embedded-pro/e-psu-hardware/simulation/results/cv_asdrawn.csv

fet | vout | rng | iload | cload | mode | fc | pm | gm | vout_meas | err
IRFP260N | 1.0 | 3A | 0.0 | 0.0 | CV | 315.00280664708674 | 37.479008982724054 |  | 1.00001945
IRFP260N | 1.0 | 3A | 0.1 | 0.0 | CV | 111112.34056282818 | -90.35583396529364 |  | 0.994687237
IRFP260N | 1.0 | 3A | 1.0 | 0.0 | CV | 180348.1509180765 | -58.49483802532512 |  | 0.949144151
IRFP260N | 1.0 | 3A | 3.0 | 0.0 | CV | 210124.91038821175 | -45.35260068004027 |  | 0.861490217
IRFP260N | 1.0 | 3A | 0.0 | 1e-06 | CV | 302.8120265973461 | 36.00394918867994 |  | 1.00001945
IRFP260N | 1.0 | 3A | 0.1 | 1e-06 | CV | 108853.3369042433 | -92.31889679006451 |  | 0.994687237
IRFP260N | 1.0 | 3A | 1.0 | 1e-06 | CV | 176492.19422361668 | -58.67569635580821 |  | 0.949144151
IRFP260N | 1.0 | 3A | 3.0 | 1e-06 | CV | 206898.11981969915 | -45.770100327446244 |  | 0.861490217
IRFP260N | 1.0 | 3A | 0.0 | 1e-05 | CV | 233.3012618310188 | 27.69359763864776 |  | 1.00001945
IRFP260N | 1.0 | 3A | 0.1 | 1e-05 | CV | 99124.26147017402 | -91.55274021964345 |  | 0.994687237
IRFP260N | 1.0 | 3A | 1.0 | 1e-05 | CV | 163498.4023783258 | -46.52654250650119 |  | 0.949144151
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
