embedded-pro/e-psu-hardware/simulation/results/cv_proposed.csv

fet | vout | rng | iload | cload | mode | fc | pm | gm | vout_meas | err
IRFP260N | 1.0 | 3A | 0.0 | 0.0 | CV | 6094.273317759308 | 53.10039724163866 |  | 1.00001878
IRFP260N | 1.0 | 3A | 0.1 | 0.0 | CV | 19683.22782733772 | 91.06813536807044 |  | 0.994687015
IRFP260N | 1.0 | 3A | 1.0 | 0.0 | CV | 21291.194335635577 | 114.20087521892174 |  | 0.949144065
IRFP260N | 1.0 | 3A | 3.0 | 0.0 | CV | 19641.96083097955 | 116.63563954116461 |  | 0.861490178
IRFP260N | 1.0 | 3A | 0.0 | 1e-06 | CV | 5811.235295453954 | 53.20892816668601 |  | 1.00001878
IRFP260N | 1.0 | 3A | 0.1 | 1e-06 | CV | 19268.304121475252 | 89.23830120658027 |  | 0.994687015
IRFP260N | 1.0 | 3A | 1.0 | 1e-06 | CV | 21255.489047157087 | 113.5764842821394 |  | 0.949144065
IRFP260N | 1.0 | 3A | 3.0 | 1e-06 | CV | 19633.887182528215 | 116.36136177612116 |  | 0.861490178
IRFP260N | 1.0 | 3A | 0.0 | 1e-05 | CV | 4197.848767816129 | 56.37407086980204 |  | 1.00001878
IRFP260N | 1.0 | 3A | 0.1 | 1e-05 | CV | 15912.252930480734 | 79.57952224761681 |  | 0.994687015
IRFP260N | 1.0 | 3A | 1.0 | 1e-05 | CV | 20459.12946863914 | 108.5170801284238 |  | 0.949144065
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
