embedded-pro/e-psu-hardware/simulation/results/cc_asdrawn.csv

fet | vout | rng | ilim | rload | cload | mode | fc | pm | gm | vout_meas | err
IRFP260N | 12.0 | 3A | 0.03 | 0.1 | 0.0 | CC | 2117.806758012487 | 121.7286767049024 |  | 0.0030139499
IRFP260N | 12.0 | 3A | 0.03 | 0.1 | 1e-05 | CC | 2118.0223184751876 | 121.7850968972673 |  | 0.0030139499
IRFP260N | 12.0 | 3A | 0.03 | 0.1 | 0.001 | CC | 2240.4994878194834 | 124.13768180821285 |  | 0.0030139499
IRFP260N | 12.0 | 3A | 0.03 | 200.0 | 0.0 | ERR |  |  |  |  | cc_asdrawn_3: no DC solution matching the settled state (settled outp=5.331337627428407)
IRFP260N | 12.0 | 3A | 0.03 | 200.0 | 1e-05 | ERR |  |  |  |  | cc_asdrawn_4: no DC solution matching the settled state (settled outp=5.331337627428407)
IRFP260N | 12.0 | 3A | 0.03 | 200.0 | 0.001 | ERR |  |  |  |  | cc_asdrawn_5: no DC solution matching the settled state (settled outp=5.331337627428407)
IRFP260N | 12.0 | 3A | 0.1 | 0.1 | 0.0 | CC | 420886.1925069952 | 92.6969536509589 |  | 0.0100130458
IRFP260N | 12.0 | 3A | 0.1 | 0.1 | 1e-05 | CC | 418921.1251776428 | 93.08625592842856 |  | 0.0100130458
IRFP260N | 12.0 | 3A | 0.1 | 0.1 | 0.001 | CC | 419078.88631668 | 93.15151834251594 |  | 0.0100130458
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
