embedded-pro/e-psu-hardware/simulation/results/cc_proposed.csv

fet | vout | rng | ilim | rload | cload | mode | fc | pm | gm | vout_meas | err
IRFP260N | 12.0 | 3A | 0.03 | 0.1 | 0.0 | CC | 5631.737068808712 | 92.26181233636237 |  | 0.0030177612
IRFP260N | 12.0 | 3A | 0.03 | 0.1 | 1e-05 | CC | 5634.6108296502 | 92.40257281657262 |  | 0.0030177612
IRFP260N | 12.0 | 3A | 0.03 | 0.1 | 0.001 | CC | 5904.620747732814 | 92.4923627222899 |  | 0.0030177612
IRFP260N | 12.0 | 3A | 0.03 | 200.0 | 0.0 | ERR |  |  |  |  | cc_proposed_3: no DC solution matching the settled state (settled outp=4.574253183991392)
IRFP260N | 12.0 | 3A | 0.03 | 200.0 | 1e-05 | ERR |  |  |  |  | cc_proposed_4: no DC solution matching the settled state (settled outp=4.574253183991392)
IRFP260N | 12.0 | 3A | 0.03 | 200.0 | 0.001 | ERR |  |  |  |  | cc_proposed_5: no DC solution matching the settled state (settled outp=4.574253183991392)
IRFP260N | 12.0 | 3A | 0.1 | 0.1 | 0.0 | CC | 12814.36105307545 | 97.10863275401658 |  | 0.0100138943
IRFP260N | 12.0 | 3A | 0.1 | 0.1 | 1e-05 | CC | 12882.797275361632 | 97.79522524652123 |  | 0.0100138943
IRFP260N | 12.0 | 3A | 0.1 | 0.1 | 0.001 | CC | 14309.509763921546 | 96.5408336981867 |  | 0.0100138943
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
