embedded-pro/e-psu-hardware/CHANGELOG.md

# Changelog

## 0.1.0 (2026-11-04)

### Documentation

* fix simulation path in project context ([42d5a3a](https://github.com/embedded-pro/e-psu-hardware/commit/42d5a3a48826d62a96e1762d63dc5f24f5c2907d))

### Miscellaneous Chores

* align repository with the e-foc-hardware layout ([08ce469](https://github.com/embedded-pro/e-psu-hardware/commit/08ce46923f95b1e13ce16b2db57f1a64f67baf07))
* align repository with the e-foc-hardware layout ([85c0ea7](https://github.com/embedded-pro/e-psu-hardware/commit/85c0ea7d61d3b7feedc3b8a030625e2e03f329c0))

## Changelog
