embedded-pro/e-psu-hardware/hardware/e-psu/e-psu.kicad_pcb

## KiCad design hardware/e-psu/e-psu.kicad_pcb (2026-11-04)

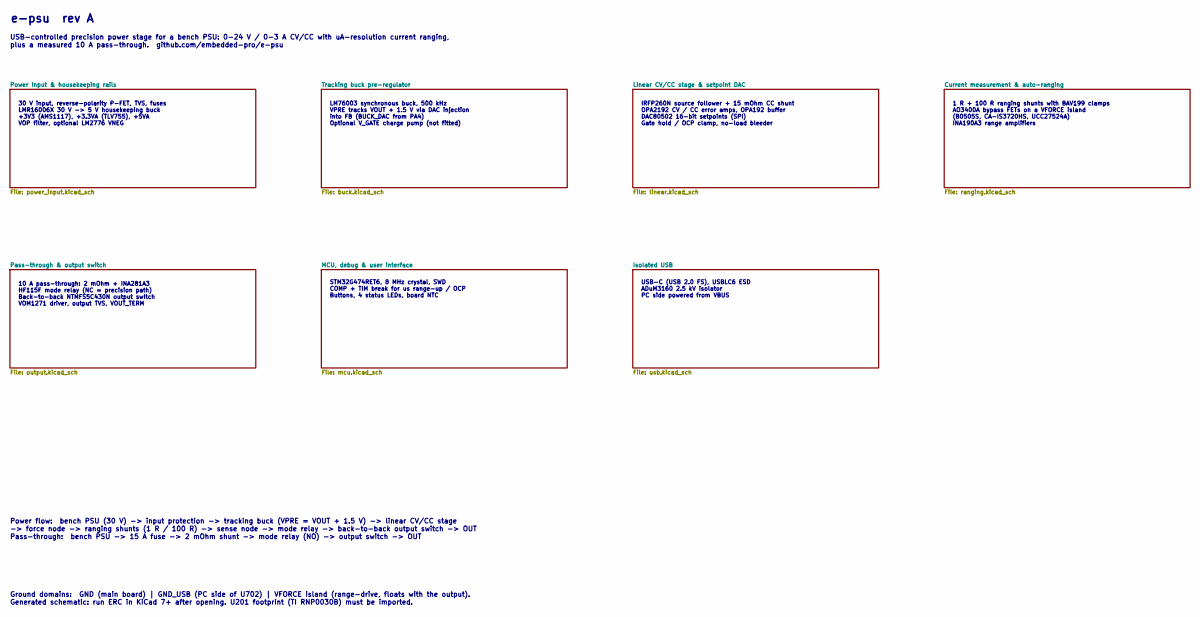
[picture p12: schematic e-psu.kicad_sch, e-psu: precision USB power stage]

Notes on the sheet:
30 V input, reverse-polarity P-FET, TVS, fuses LMR16006X 30 V -> 5 V housekeeping buck +3V3 (AMS1117), +3.3VA (TLV755), +5VA VOP filter, optional LM2776 VNEG
LM76003 synchronous buck, 500 kHz VPRE tracks VOUT + 1.5 V via DAC injection into FB (BUCK_DAC from PA4) Optional V_GATE charge pump (not fitted)
IRFP260N source follower + 15 mOhm CC shunt OPA2192 CV / CC error amps, OPA192 buffer DAC80502 16-bit setpoints (SPI) Gate hold / OCP clamp, no-load bleeder
1 R + 100 R ranging shunts with BAV199 clamps AO3400A bypass FETs on a VFORCE island (B0505S, CA-IS3720HS, UCC27524A) INA190A3 range amplifiers
10 A pass-through: 2 mOhm + INA281A3 HF115F mode relay (NC = precision path) Back-to-back NTMFS5C430N output switch VOM1271 driver, output TVS, VOUT_TERM
STM32G474RET6, 8 MHz crystal, SWD COMP + TIM break for us range-up / OCP Buttons, 4 status LEDs, board NTC
USB-C (USB 2.0 FS), USBLC6 ESD ADuM3160 2.5 kV isolator PC side powered from VBUS
e-psu rev A
USB-controlled precision power stage for a bench PSU: 0-24 V / 0-3 A CV/CC with uA-resolution current ranging, plus a measured 10 A pass-through. github.com/embedded-pro/e-psu
Power flow: bench PSU (30 V) -> input protection -> tracking buck (VPRE = VOUT + 1.5 V) -> linear CV/CC stage -> force node -> ranging shunts (1 R / 100 R) -> sense node -> mode relay -> back-to-back output switch -> OUT Pass-through: bench PSU -> 15 A fuse -> 2 mOhm shunt -> mode relay (NO) -> out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
Ground domains: GND (main board) | GND_USB (PC side of U702) | VFORCE island (range-drive, floats with the output). Generated schematic: run ERC in KiCad 7+ after opening. U201 footprint (TI RNP0030B) must be imported.

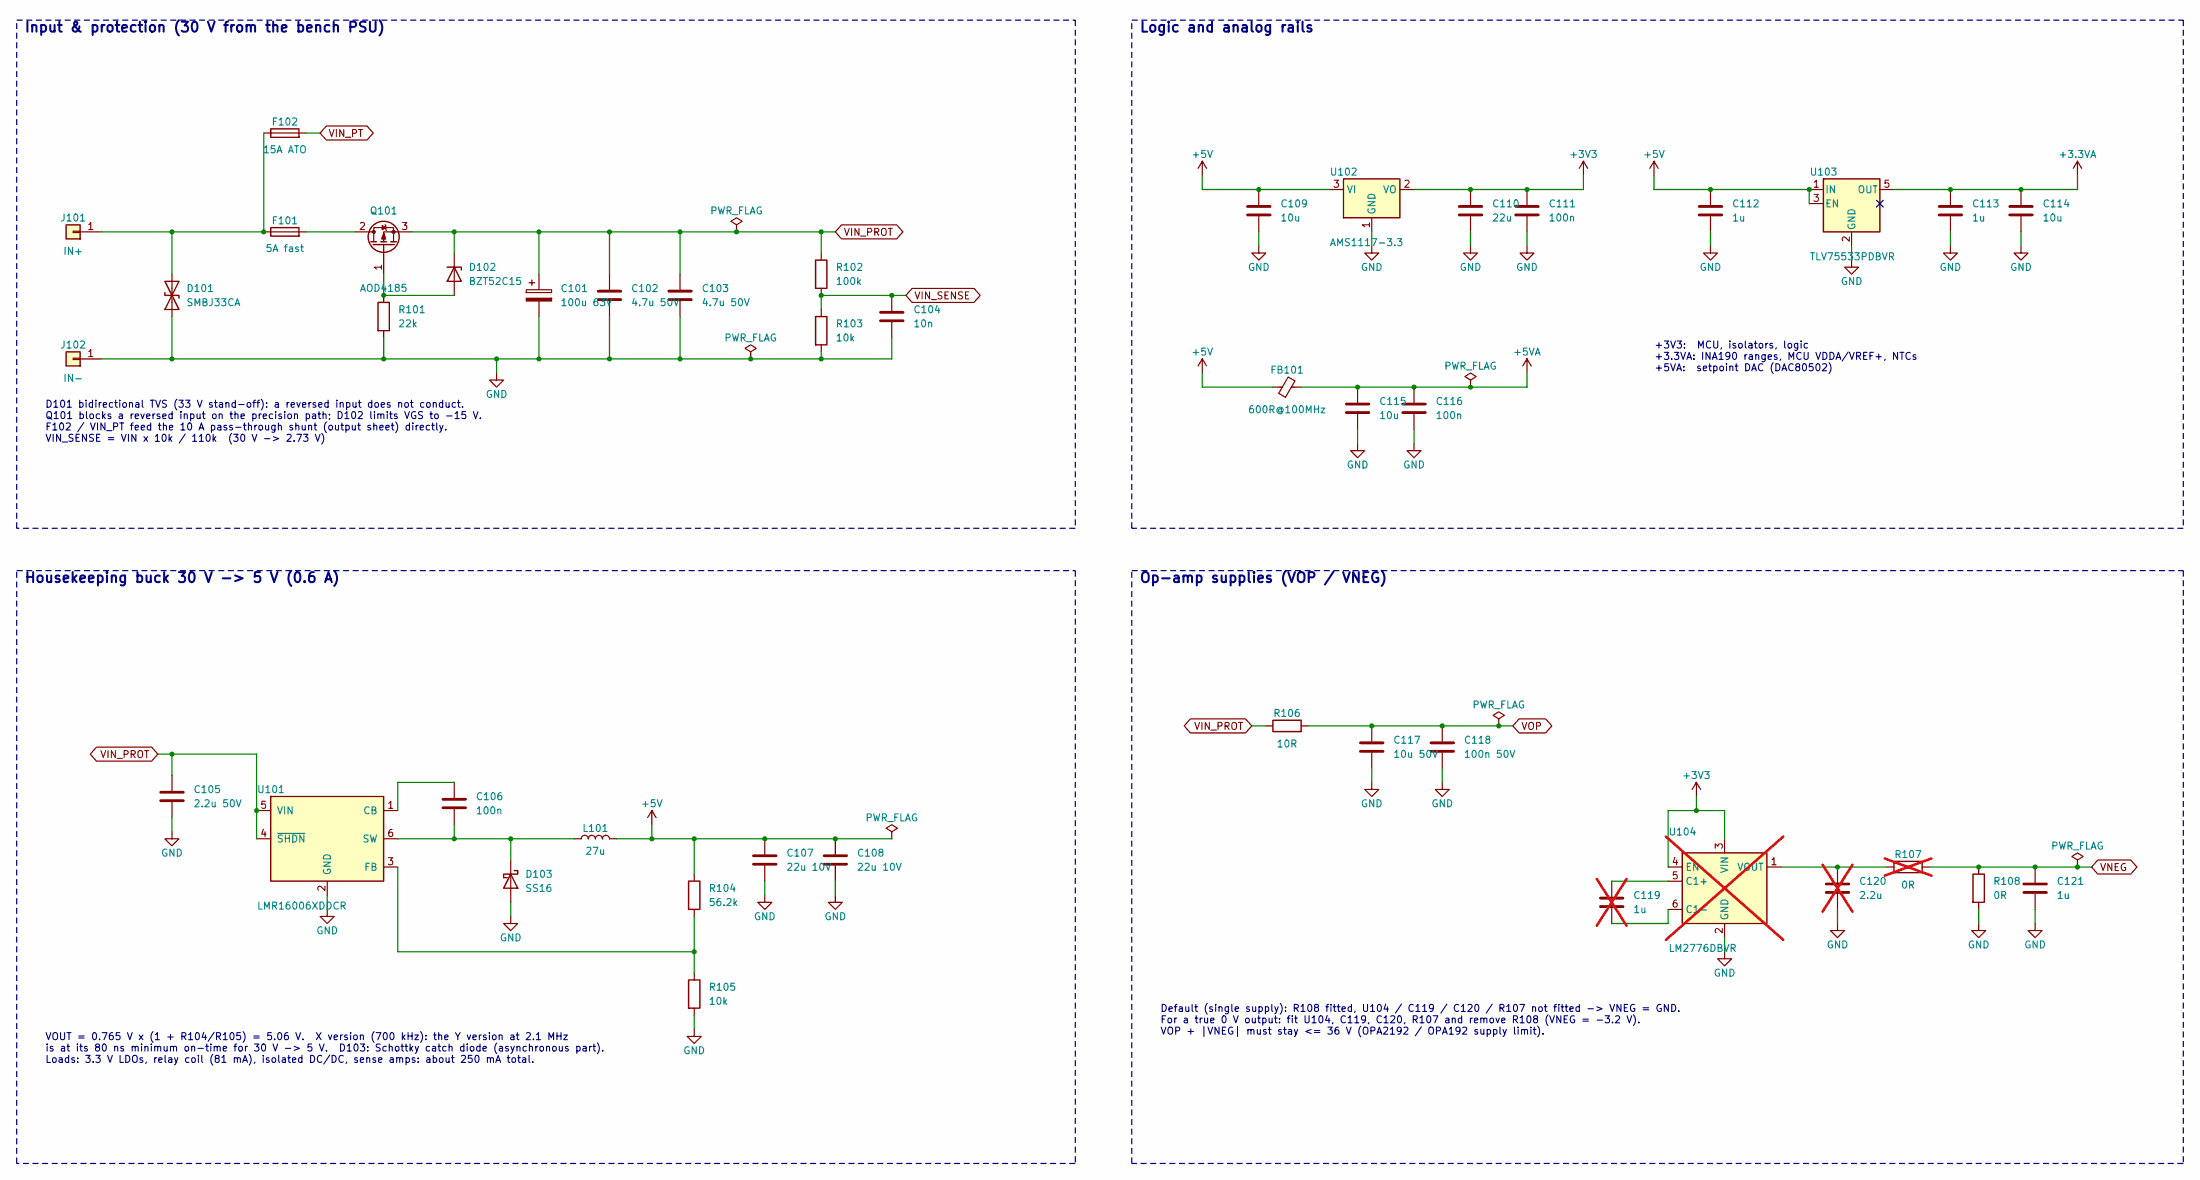
[picture p13: schematic power_input.kicad_sch, Power input & housekeeping rails]

Parts:
C101: 100u 63V; CP_Elec_10x10.5
C102, C103: 4.7u 50V; C_1210_3225Metric
C104: 10n; C_0603_1608Metric
C105: 2.2u 50V; C_1206_3216Metric
C106, C111, C116: 100n; C_0603_1608Metric
C107, C108: 22u 10V; C_0805_2012Metric
C109, C114, C115: 10u; C_0805_2012Metric
C110: 22u; C_1206_3216Metric
C112, C113, C121: 1u; C_0603_1608Metric
C117: 10u 50V; C_1210_3225Metric
C118: 100n 50V; C_0603_1608Metric
C119: 1u; C_0603_1608Metric; not fitted
C120: 2.2u; C_0603_1608Metric; not fitted
D101: SMBJ33CA; D_SMB; MPN SMBJ33CA (bidirectional)
D102: BZT52C15; D_SOD-123
D103: SS16; D_SMA
F101: 5A fast; Fuse_Littelfuse-NANO2-451_453; MPN Littelfuse 0451005.MRL (NANO2 5 A)
F102: 15A ATO; FuseHolder_Blade_ATO_Littelfuse_FLR_178.6165; MPN ATO blade fuse 15 A + PCB holder
FB101: 600R@100MHz; L_0805_2012Metric
J101: IN+; Banana_Cliff_FCR7350R_S16N-PC_Horizontal; MPN Cliff FCR7350R (4 mm, 16 A)
J102: IN-; Banana_Cliff_FCR7350B_S16N-PC_Horizontal; MPN Cliff FCR7350B (4 mm, 16 A)
L101: 27u; L_Sunlord_SWPA5040S; MPN 27 uH, Isat >= 1 A (e.g. Sunlord SWPA50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
Q101: AOD4185; TO-252-2; MPN AOD4185 (-40 V, 40 A, DPAK)
R101: 22k; R_0603_1608Metric
R102: 100k; R_0603_1608Metric
R103, R105: 10k; R_0603_1608Metric
R104: 56.2k; R_0603_1608Metric
R106: 10R; R_0805_2012Metric
R107: 0R; R_0603_1608Metric; not fitted
R108: 0R; R_0603_1608Metric
U101: LMR16006XDDCR; SOT-23-6; MPN TI LMR16006XDDCR (700 kHz)
U102: AMS1117-3.3; SOT-223-3_TabPin2; LCSC C6186
U103: TLV75533PDBVR; SOT-23-5; LCSC C404027
U104: LM2776DBVR; SOT-23-6; LCSC C69527; not fitted

Connections:
+3.3VA: C113.1, C114.1, U103.5 (OUT); also elsewhere on the board
+3V3: C110.1, C111.1, U102.2 (VO), U104.3 (VIN), U104.4 (EN); also elsewhere on the board
+5V: C107.1, C108.1, C109.1, C112.1, FB101.1, L101.2, R104.1, U102.3 (VI), U103.1 (IN), U103.3 (EN); also elsewhere on the board
+5VA: C115.1, C116.1, FB101.2; also elsewhere on the board
GND: C101.2, C102.2, C103.2, C104.2, C105.2, C107.2, C108.2, C109.2, C110.2, C111.2, C112.2, C113.2, C114.2, C115.2, C116.2, C117.2, C118.2, C120.2, C121.2, D101.1 (A1), D103.2 (A), J102.1, R101.2, R103.2, R105.2, R108.2, U101.2 (GND), U102.1 (GND), U103.2 (GND), U104.2 (GND); also elsewhere on the board
unnamed: D101.2 (A2), F101.1, F102.1, J101.1
unnamed: D102.2 (A), Q101.1 (G), R101.1
unnamed: C106.2, D103.1 (K), L101.1, U101.6 (SW)
unnamed: F101.2, Q101.2 (D)
unnamed: C106.1, U101.1 (CB)
unnamed: R104.2, R105.1, U101.3 (FB)
unnamed: C119.1, U104.5 (C1+)
unnamed: C119.2, U104.6 (C1-)
unnamed: C120.1, R107.1, U104.1 (VOUT)
VIN_PROT: C101.1, C102.1, C103.1, C105.1, D102.1 (K), Q101.3 (S), R102.1, R106.1, U101.4 (~SHDN), U101.5 (VIN); also elsewhere on the board
VIN_PT: F102.2; also elsewhere on the board
VIN_SENSE: C104.1, R102.2, R103.1; also elsewhere on the board
VNEG: C121.1, R107.2, R108.1; also elsewhere on the board
VOP: C117.1, C118.1, R106.2; also elsewhere on the board

Notes on the sheet:
Input & protection (30 V from the bench PSU)
D101 bidirectional TVS (33 V stand-off): a reversed input does not conduct. Q101 blocks a reversed input on the precision path; D102 limits VGS to -15 V. F102 / VIN_PT feed the 10 A pass-through shunt (output sheet) directly. VIN_SENSE = VIN x 10k / 110k (30 V -> 2.73 V)
Housekeeping buck 30 V -> 5 V (0.6 A)
VOUT = 0.765 V x (1 + R104/R105) = 5.06 V. X version (700 kHz): the Y version at 2.1 MHz is at its 80 ns minimum on-time for 30 V -> 5 V. D103: Schottky catch diode (asynchronous part). Loads: 3.3 V LDOs, relay coil (81 mA), isolated DC/DC, sense amps: about 250 mA total.
Logic and analog rails
+3V3: MCU, isolators, logic +3.3VA: INA190 ranges, MCU VDDA/VREF+, NTCs +5VA: setpoint DAC (DAC80502)
Op-amp supplies (VOP / VNEG)
Default (single supply): R108 fitted, U104 / C119 / C120 / R107 not fitted -> VNEG = GND. For a true 0 V output: fit U104, C119, C120, R107 and remove R108 (VNEG = -3.2 V). VOP + |VNEG| must stay <= 36 V (OPA2192 / OPA192 supply limit).

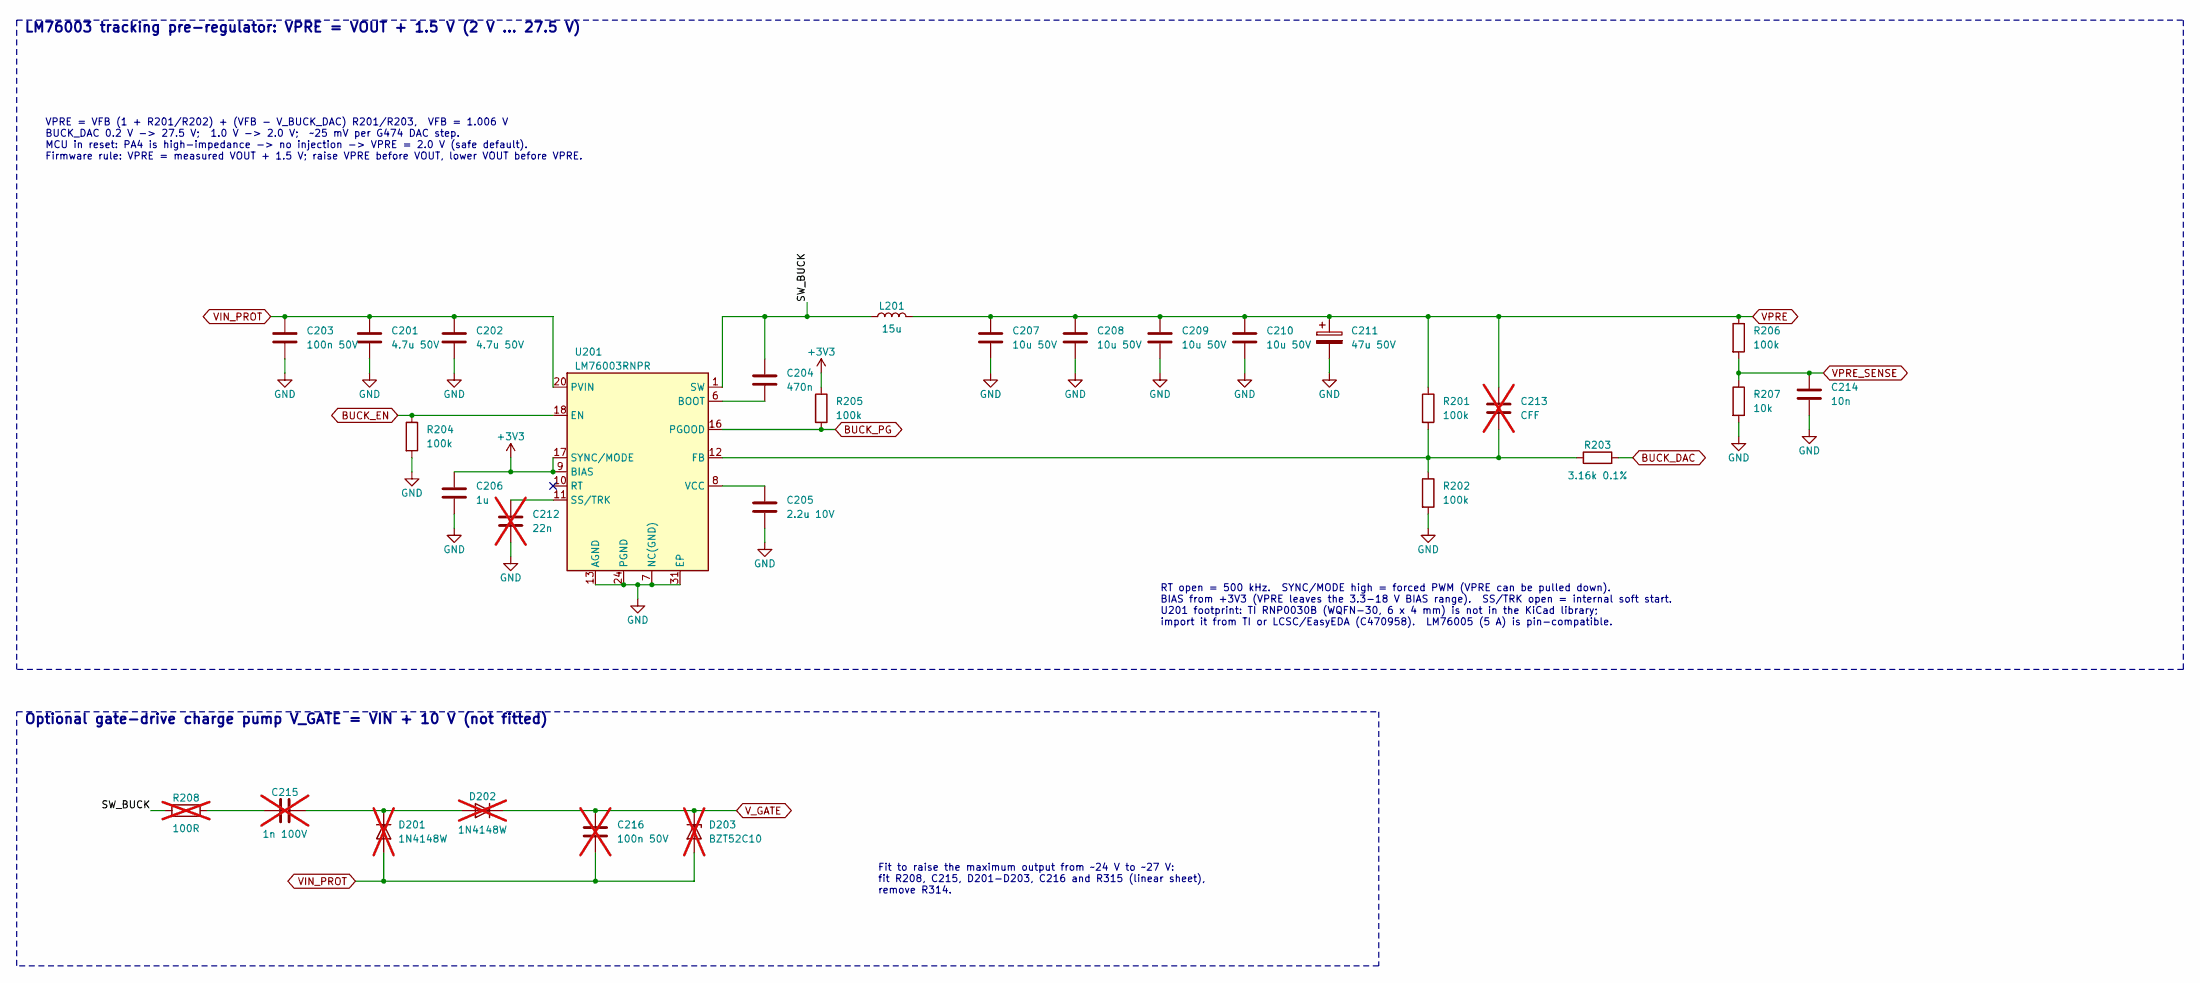
[picture p14: schematic buck.kicad_sch, Tracking buck pre-regulator]

Parts:
C201, C202: 4.7u 50V; C_1210_3225Metric
C203: 100n 50V; C_0603_1608Metric
C204: 470n; C_0603_1608Metric
C205: 2.2u 10V; C_0603_1608Metric
C206: 1u; C_0603_1608Metric
C207, C208, C209, C210: 10u 50V; C_1210_3225Metric
C211: 47u 50V; CP_Elec_8x10
C212: 22n; C_0603_1608Metric; not fitted
C213: CFF; C_0603_1608Metric; not fitted
C214: 10n; C_0603_1608Metric
C215: 1n 100V; C_0603_1608Metric; not fitted
C216: 100n 50V; C_0603_1608Metric; not fitted
D201, D202: 1N4148W; D_SOD-123; not fitted
D203: BZT52C10; D_SOD-123; not fitted
L201: 15u; L_Wuerth_HCI-1350; MPN FANGCHENG FCH1365-150M (Isat 12 A); LCSC C20415554
R201, R202, R204, R205, R206: 100k; R_0603_1608Metric
R203: 3.16k 0.1%; R_0603_1608Metric
R207: 10k; R_0603_1608Metric
R208: 100R; R_0603_1608Metric; not fitted
U201: LM76003RNPR; TI_RNP0030B_WQFN-30; MPN TI LM76003RNPR; LCSC C470958

Connections:
+3V3: C206.1, R205.1, U201.9 (BIAS), U201.17 (SYNC/MODE); also elsewhere on the board
/Tracking buck pre-regulator/SW_BUCK: C204.1, L201.1, R208.1, U201.1 (SW), U201.2 (SW), U201.3 (SW), U201.4 (SW), U201.5 (SW)
BUCK_DAC: R203.2; also elsewhere on the board
BUCK_EN: R204.1, U201.18 (EN); also elsewhere on the board
BUCK_PG: R205.2, U201.16 (PGOOD); also elsewhere on the board
GND: C201.2, C202.2, C203.2, C205.2, C206.2, C207.2, C208.2, C209.2, C210.2, C211.2, C212.2, C214.2, R202.2, R204.2, R207.2, U201.7 (NC(GND)), U201.13 (AGND), U201.14 (AGND), U201.15 (AGND), U201.19 (NC(GND)), U201.23 (NC(GND)), U201.24 (PGND), U201.25 (PGND), U201.26 (PGND), U201.27 (NC(GND)), U201.28 (NC(GND)), U201.29 (NC(GND)), U201.30 (NC(GND)), U201.31 (EP); also elsewhere on the board
unnamed: C215.1, R208.2
unnamed: C215.2, D201.1 (K), D202.2 (A)
unnamed: C204.2, U201.6 (BOOT)
unnamed: C213.2, R201.2, R202.1, R203.1, U201.12 (FB)
unnamed: C212.1, U201.11 (SS/TRK)
unnamed: C205.1, U201.8 (VCC)
VIN_PROT: C201.1, C202.1, C203.1, C216.2, D201.2 (A), D203.2 (A), U201.20 (PVIN), U201.21 (PVIN), U201.22 (PVIN); also elsewhere on the board
VPRE: C207.1, C208.1, C209.1, C210.1, C211.1, C213.1, L201.2, R201.1, R206.1; also elsewhere on the board
VPRE_SENSE: C214.1, R206.2, R207.1; also elsewhere on the board
V_GATE: C216.1, D202.1 (K), D203.1 (K); also elsewhere on the board

Notes on the sheet:
LM76003 tracking pre-regulator: VPRE = VOUT + 1.5 V (2 V ... 27.5 V)
VPRE = VFB (1 + R201/R202) + (VFB - V_BUCK_DAC) R201/R203, VFB = 1.006 V BUCK_DAC 0.2 V -> 27.5 V; 1.0 V -> 2.0 V; ~25 mV per G474 DAC step. MCU in reset: PA4 is high-impedance -> no injection -> VPRE = 2.0 V (safe default). Firmware rule: VPRE = measured VOUT + 1.5 V; raise VPRE before VOUT, lower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
RT open = 500 kHz. SYNC/MODE high = forced PWM (VPRE can be pulled down). BIAS from +3V3 (VPRE leaves the 3.3-18 V BIAS range). SS/TRK open = internal soft start. U201 footprint: TI RNP0030B (WQFN-30, 6 x 4 mm) is not in the KiCad library; import it from TI or LCSC/EasyEDA (C470958). LM76005 (5 A) 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
Optional gate-drive charge pump V_GATE = VIN + 10 V (not fitted)
Fit to raise the maximum output from ~24 V to ~27 V: fit R208, C215, D201-D203, C216 and R315 (linear sheet), remove R314.

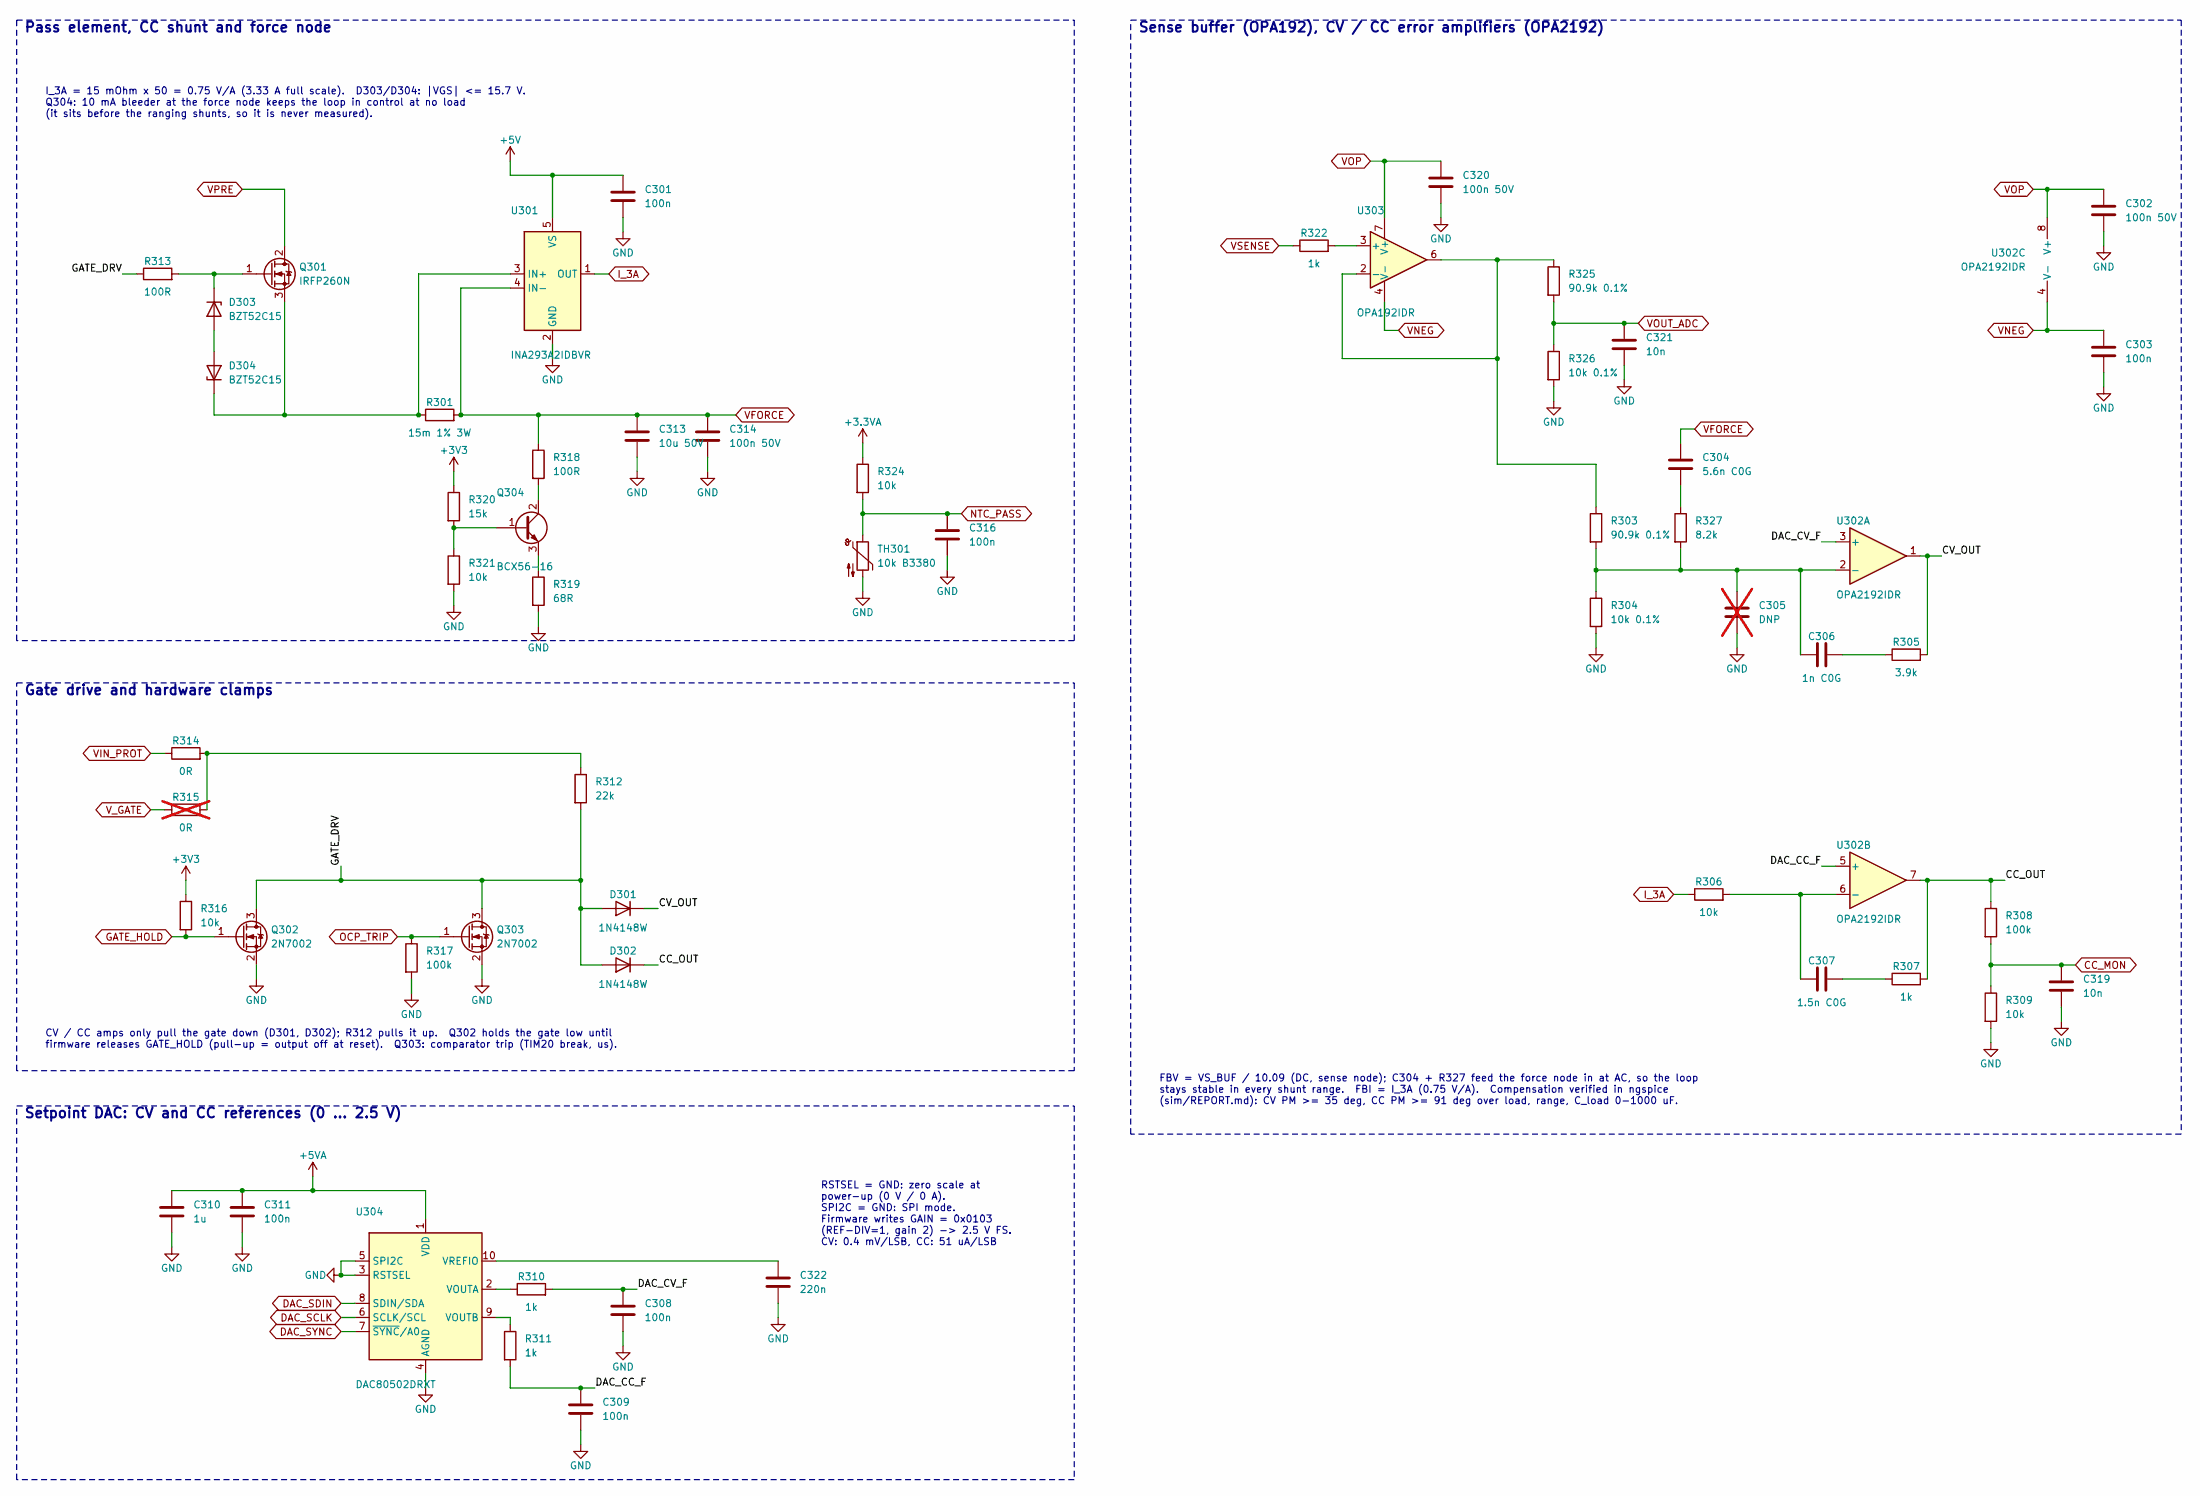
[picture p15: schematic linear.kicad_sch, Linear CV/CC stage & setpoint DAC]

Parts:
C301, C303, C308, C309, C311, C316: 100n; C_0603_1608Metric
C302, C314, C320: 100n 50V; C_0603_1608Metric
C304: 5.6n C0G; C_0603_1608Metric
C305: DNP; C_0603_1608Metric; not fitted
C306: 1n C0G; C_0603_1608Metric
C307: 1.5n C0G; C_0603_1608Metric
C310: 1u; C_0603_1608Metric
C313: 10u 50V; C_1210_3225Metric
C319, C321: 10n; C_0603_1608Metric
C322: 220n; C_0603_1608Metric
D301, D302: 1N4148W; D_SOD-123
D303, D304: BZT52C15; D_SOD-123
Q301: IRFP260N; TO-247-3_Vertical; MPN Infineon IRFP260NPBF on heatsink (or a 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; LCSC C2678
Q302, Q303: 2N7002; SOT-23
Q304: BCX56-16; SOT-89-3; MPN BCX56-16 (SOT-89, 1 W): ~0.25 W at 24 V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
R301: 15m 1% 3W; R_2512_6332Metric; LCSC C459682
R303, R325: 90.9k 0.1%; R_0603_1608Metric
R304, R326: 10k 0.1%; R_0603_1608Metric
R305: 3.9k; R_0603_1608Metric
R306, R309, R316, R321, R324: 10k; R_0603_1608Metric
R307, R310, R311, R322: 1k; R_0603_1608Metric
R308, R317: 100k; R_0603_1608Metric
R312: 22k; R_0603_1608Metric
R313, R318: 100R; R_0603_1608Metric
R314: 0R; R_0603_1608Metric
R315: 0R; R_0603_1608Metric; not fitted
R319: 68R; R_0805_2012Metric
R320: 15k; R_0603_1608Metric
R327: 8.2k; R_0603_1608Metric
TH301: 10k B3380; R_0603_1608Metric; MPN Murata NCP18XH103F03RB, on the heatsink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; LCSC C13564
U301: INA293A2IDBVR; SOT-23-5; LCSC C1855792
U302: OPA2192IDR; SOIC-8_3.9x4.9mm_P1.27mm; LCSC C110074
U303: OPA192IDR; SOIC-8_3.9x4.9mm_P1.27mm; LCSC C2861286
U304: DAC80502DRXT; Texas_DRX_WSON-10_2.5x2.5mm_P0.5mm; LCSC C2861168

Connections:
+3.3VA: R324.1; also elsewhere on the board
+3V3: R316.1, R320.1; also elsewhere on the board
+5V: C301.1, U301.5 (VS); also elsewhere on the board
+5VA: C310.1, C311.1, U304.1 (VDD); also elsewhere on the board
/Linear CV/CC stage & setpoint DAC/CC_OUT: D302.1 (K), R307.2, R308.1, U302.7
/Linear CV/CC stage & setpoint DAC/CV_OUT: D301.1 (K), R305.2, U302.1
/Linear CV/CC stage & setpoint DAC/DAC_CC_F: C309.1, R311.2, U302.5 (+)
/Linear CV/CC stage & setpoint DAC/DAC_CV_F: C308.1, R310.2, U302.3 (+)
/Linear CV/CC stage & setpoint DAC/GATE_DRV: D301.2 (A), D302.2 (A), Q302.3 (D), Q303.3 (D), R312.2, R313.1
CC_MON: C319.1, R308.2, R309.1; also elsewhere on the board
DAC_SCLK: U304.6 (SCLK/SCL); also elsewhere on the board
DAC_SDIN: U304.8 (SDIN/SDA); also elsewhere on the board
DAC_SYNC: U304.7 (~SYNC/A0); also elsewhere on the board
GATE_HOLD: Q302.1 (G), R316.2; also elsewhere on the board
GND: C301.2, C302.2, C303.2, C305.2, C308.2, C309.2, C310.2, C311.2, C313.2, C314.2, C316.2, C319.2, C320.2, C321.2, C322.2, Q302.2 (S), Q303.2 (S), R304.2, R309.2, R317.2, R319.2, R321.2, R326.2, TH301.2, U301.2 (GND), U304.3 (RSTSEL), U304.4 (AGND), U304.5 (SPI2C); also elsewhere on the board
I_3A: R306.1, U301.1 (OUT); also elsewhere on the board
NTC_PASS: C316.1, R324.2, TH301.1; also elsewhere on the board
unnamed: C304.2, R327.1
unnamed: C306.2, R305.1
unnamed: C307.2, R307.1
unnamed: D303.2 (A), D304.2 (A)
unnamed: D303.1 (K), Q301.1 (G), R313.2
unnamed: D304.1 (K), Q301.3 (S), R301.1, U301.3 (IN+)
unnamed: Q304.1 (B), R320.2, R321.1
unnamed: Q304.2 (C), R318.2
unnamed: Q304.3 (E), R319.1
unnamed: R312.1, R314.2, R315.2
unnamed: C305.1, C306.1, R303.2, R304.1, R327.2, U302.2 (-)
unnamed: C307.1, R306.2, U302.6 (-)
unnamed: R322.2, U303.3 (+)
unnamed: R303.1, R325.1, U303.2 (-), U303.6
unnamed: R310.1, U304.2 (VOUTA)
unnamed: R311.1, U304.9 (VOUTB)
unnamed: C322.1, U304.10 (VREFIO)
OCP_TRIP: Q303.1 (G), R317.1; also elsewhere on the board
VFORCE: C304.1, C313.1, C314.1, R301.2, R318.1, U301.4 (IN-); also elsewhere on the board
VIN_PROT: R314.1; also elsewhere on the board
VNEG: C303.1, U302.4 (V-), U303.4 (V-); also elsewhere on the board
VOP: C302.1, C320.1, U302.8 (V+), U303.7 (V+); also elsewhere on the board
VOUT_ADC: C321.1, R325.2, R326.1; also elsewhere on the board
VPRE: Q301.2 (D); also elsewhere on the board
VSENSE: R322.1; also elsewhere on the board
V_GATE: R315.1; also elsewhere on the board

Notes on the sheet:
Pass element, CC shunt and force node
I_3A = 15 mOhm x 50 = 0.75 V/A (3.33 A full scale). D303/D304: |VGS| <= 15.7 V. Q304: 10 mA bleeder at the force node keeps the loop in control at no load (it sits before the ranging shunts, so it is never measured).
Gate drive and hardware clamps
CV / CC amps only pull the gate down (D301, D302); R312 pulls it up. Q302 holds the gate low until firmware releases GATE_HOLD (pull-up = output off at reset). Q303: comparator trip (TIM20 break, us).
Setpoint DAC: CV and CC references (0 ... 2.5 V)
RSTSEL = GND: zero scale at power-up (0 V / 0 A). SPI2C = GND: SPI mode. Firmware writes GAIN = 0x0103 (REF-DIV=1, gain 2) -> 2.5 V FS. CV: 0.4 mV/LSB, CC: 51 uA/LSB
Sense buffer (OPA192), CV / CC error amplifiers (OPA2192)
FBV = VS_BUF / 10.09 (DC, sense node); C304 + R327 feed the force node in at AC, so the loop stays stable in every shunt range. FBI = I_3A (0.75 V/A). Compensation verified in ngspice (sim/REPORT.md): CV PM >= 35 deg, CC PM >= 91 deg over load, range, C_load 0-1000 uF.

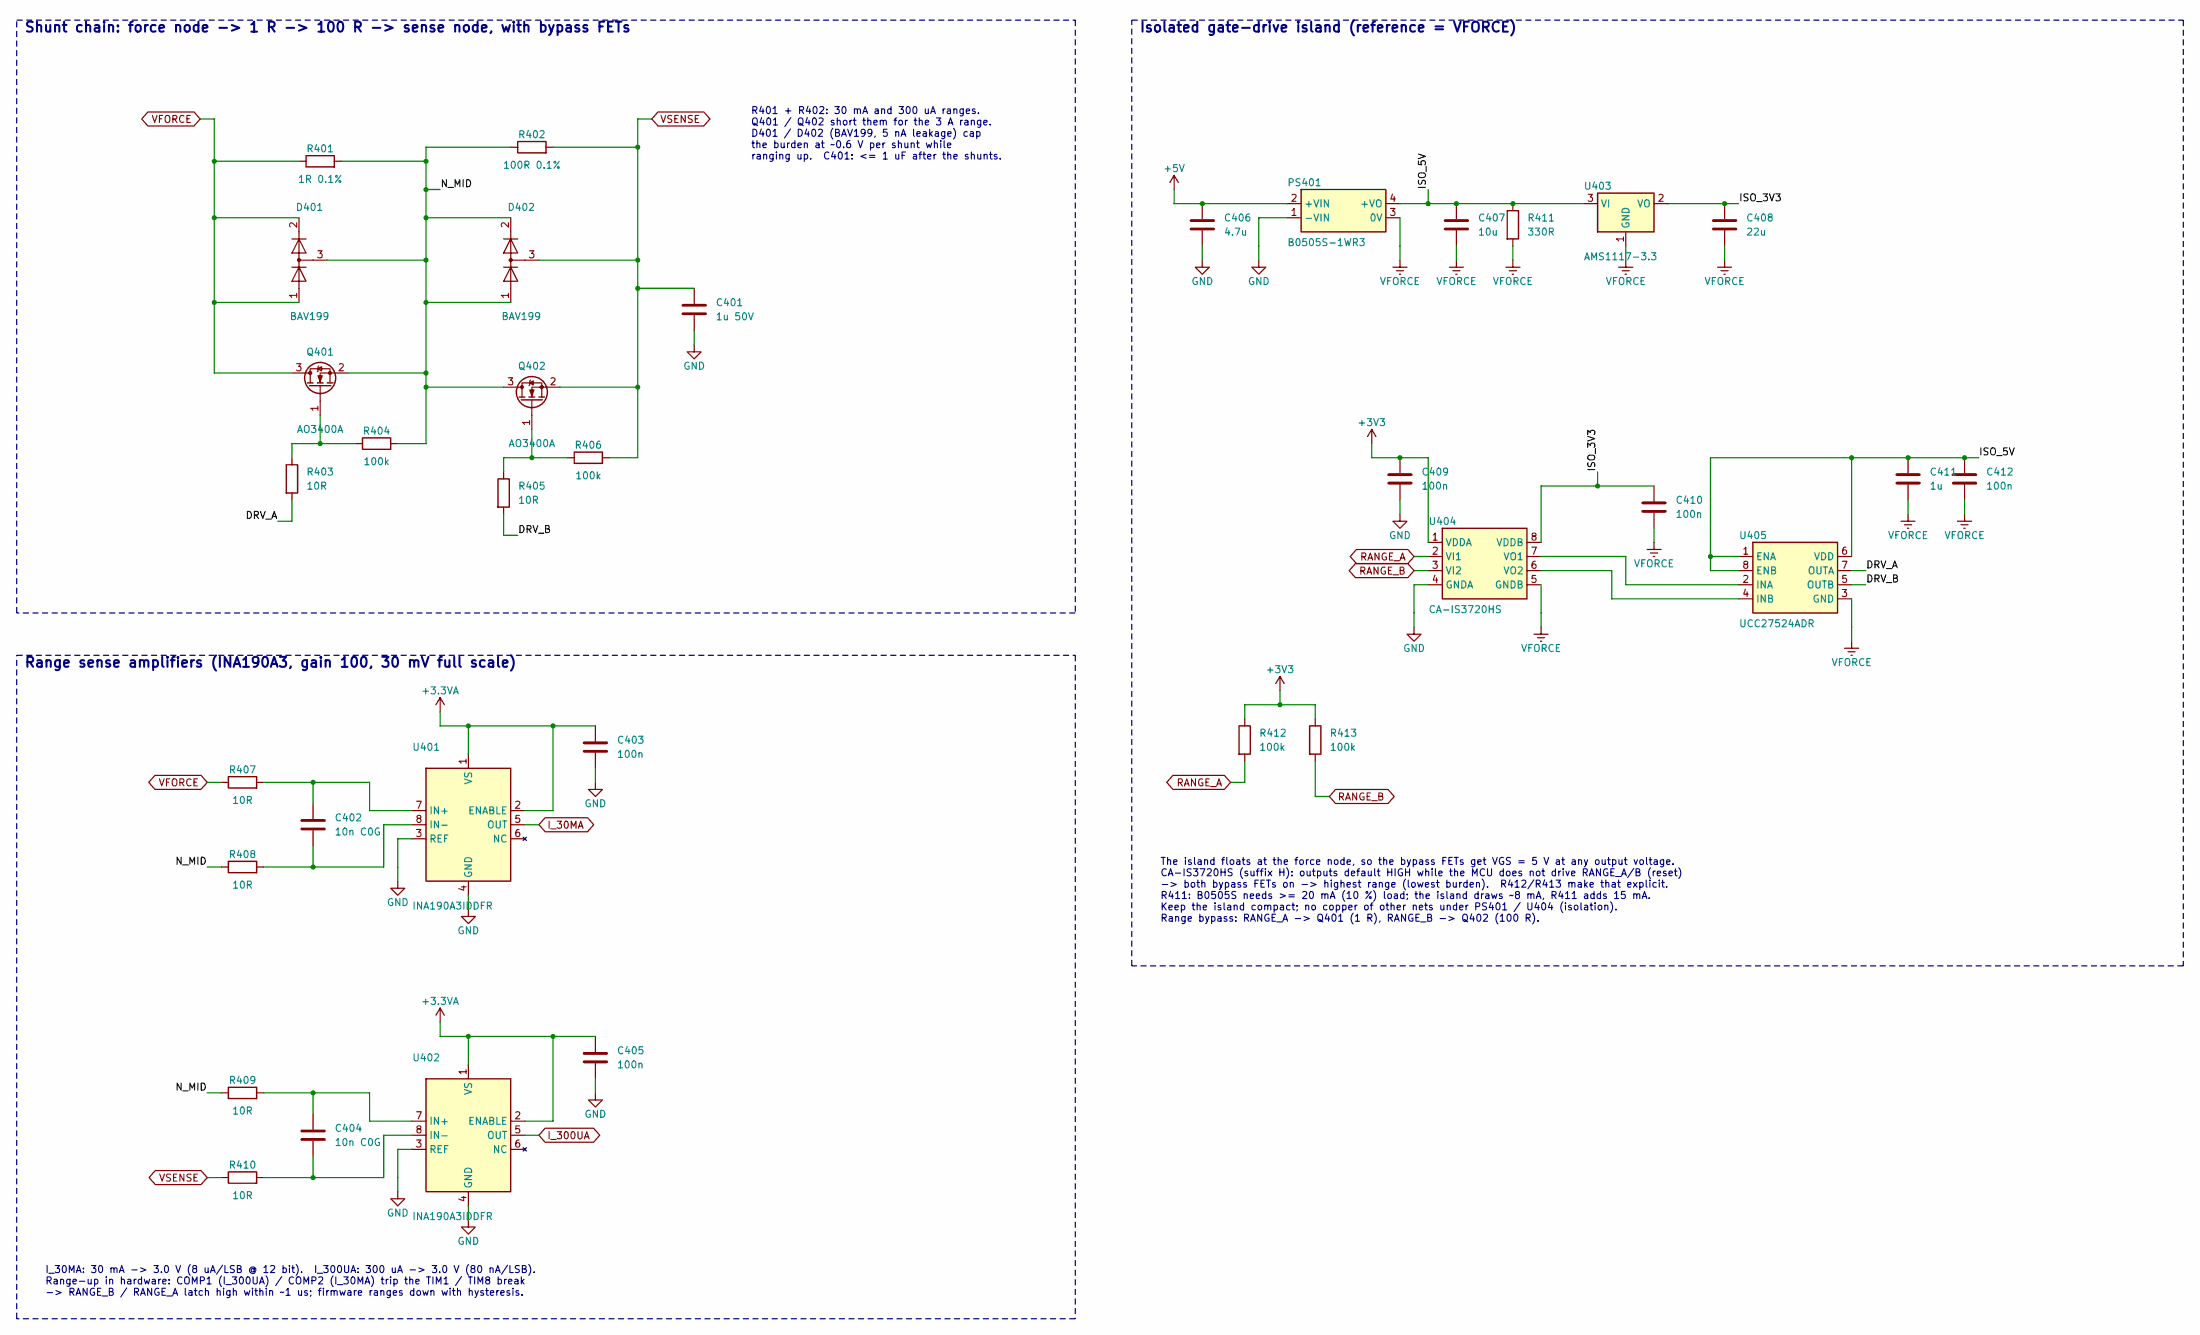
[picture p16: schematic ranging.kicad_sch, Current measurement & auto-ranging]

Parts:
C401: 1u 50V; C_0805_2012Metric
C402, C404: 10n C0G; C_0603_1608Metric
C403, C405, C409, C410, C412: 100n; C_0603_1608Metric
C406: 4.7u; C_0805_2012Metric
C407: 10u; C_1206_3216Metric
C408: 22u; C_1206_3216Metric
C411: 1u; C_0603_1608Metric
D401, D402: BAV199; SOT-23; LCSC C40919
PS401: B0505S-1WR3; Converter_DCDC_Murata_MEE1SxxxxSC_THT; MPN B0505S-1WR3 (1 W, SIP-4; verify pinout 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; LCSC C2992394
Q401, Q402: AO3400A; SOT-23; LCSC C20917
R401: 1R 0.1%; R_0805_2012Metric; LCSC C865286
R402: 100R 0.1%; R_0805_2012Metric; LCSC C110773
R403, R405, R407, R408, R409, R410: 10R; R_0603_1608Metric
R404, R406, R412, R413: 100k; R_0603_1608Metric
R411: 330R; R_0805_2012Metric
U401, U402: INA190A3IDDFR; SOT-23-8; LCSC C1852076
U403: AMS1117-3.3; SOT-223-3_TabPin2; LCSC C6186
U404: CA-IS3720HS; SOIC-8_3.9x4.9mm_P1.27mm; LCSC C428882
U405: UCC27524ADR; SOIC-8_3.9x4.9mm_P1.27mm; LCSC C185857

Connections:
+3.3VA: C403.1, C405.1, U401.1 (VS), U401.2 (ENABLE), U402.1 (VS), U402.2 (ENABLE); also elsewhere on the board
+3V3: C409.1, R412.1, R413.1, U404.1 (VDDA); also elsewhere on the board
+5V: C406.1, PS401.2 (+VIN); also elsewhere on the board
/Current measurement & auto-ranging/DRV_A: R403.2, U405.7 (OUTA)
/Current measurement & auto-ranging/DRV_B: R405.2, U405.5 (OUTB)
/Current measurement & auto-ranging/ISO_3V3: C408.1, C410.1, U403.2 (VO), U404.8 (VDDB)
/Current measurement & auto-ranging/ISO_5V: C407.1, C411.1, C412.1, PS401.4 (+VO), R411.1, U403.3 (VI), U405.1 (ENA), U405.6 (VDD), U405.8 (ENB)
/Current measurement & auto-ranging/N_MID: D401.3 (K), D402.1 (K), D402.2 (A), Q401.2 (S), Q402.3 (D), R401.2, R402.1, R404.2, R408.1, R409.1
GND: C401.2, C403.2, C405.2, C406.2, C409.2, PS401.1 (-VIN), U401.3 (REF), U401.4 (GND), U402.3 (REF), U402.4 (GND), U404.4 (GNDA); also elsewhere on the board
I_30MA: U401.5 (OUT); also elsewhere on the board
I_300UA: U402.5 (OUT); also elsewhere on the board
unnamed: Q401.1 (G), R403.1, R404.1
unnamed: Q402.1 (G), R405.1, R406.1
unnamed: C402.1, R407.2, U401.7 (IN+)
unnamed: C402.2, R408.2, U401.8 (IN-)
unnamed: C404.1, R409.2, U402.7 (IN+)
unnamed: C404.2, R410.2, U402.8 (IN-)
unnamed: U404.7 (VO1), U405.2 (INA)
unnamed: U404.6 (VO2), U405.4 (INB)
RANGE_A: R412.2, U404.2 (VI1); also elsewhere on the board
RANGE_B: R413.2, U404.3 (VI2); also elsewhere on the board
VFORCE: C407.2, C408.2, C410.2, C411.2, C412.2, D401.1 (K), D401.2 (A), PS401.3 (0V), Q401.3 (D), R401.1, R407.1, R411.2, U403.1 (GND), U404.5 (GNDB), U405.3 (GND); also elsewhere on the board
VSENSE: C401.1, D402.3 (K), Q402.2 (S), R402.2, R406.2, R410.1; also elsewhere on the board

Notes on the sheet:
Shunt chain: force node -> 1 R -> 100 R -> sense node, with bypass FETs
R401 + R402: 30 mA and 300 uA ranges. Q401 / Q402 short them for the 3 A range. D401 / D402 (BAV199, 5 nA leakage) cap the burden at ~0.6 V per shunt while ranging up. C401: <= 1 uF after the shunts.
Range sense amplifiers (INA190A3, gain 100, 30 mV full scale)
I_30MA: 30 mA -> 3.0 V (8 uA/LSB @ 12 bit). I_300UA: 300 uA -> 3.0 V (80 nA/LSB). Range-up in hardware: COMP1 (I_300UA) / COMP2 (I_30MA) trip the TIM1 / TIM8 break -> RANGE_B / RANGE_A latch high within ~1 us; firmware ranges down with hysteresis.
Isolated gate-drive island (reference = VFORCE)
The island floats at the force node, so the bypass FETs get VGS = 5 V at any output voltage. CA-IS3720HS (suffix H): outputs default HIGH while the MCU does not drive RANGE_A/B (reset) -> both bypass FETs on -> highest range (lowest burden). R412/R413 make that explicit. R411: B0505S needs >= 20 mA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
