embedded-pro/e-psu-hardware/hardware/e-psu/e-psu.kicad_pcb

## KiCad design hardware/e-psu/e-psu.kicad_pcb (continued)

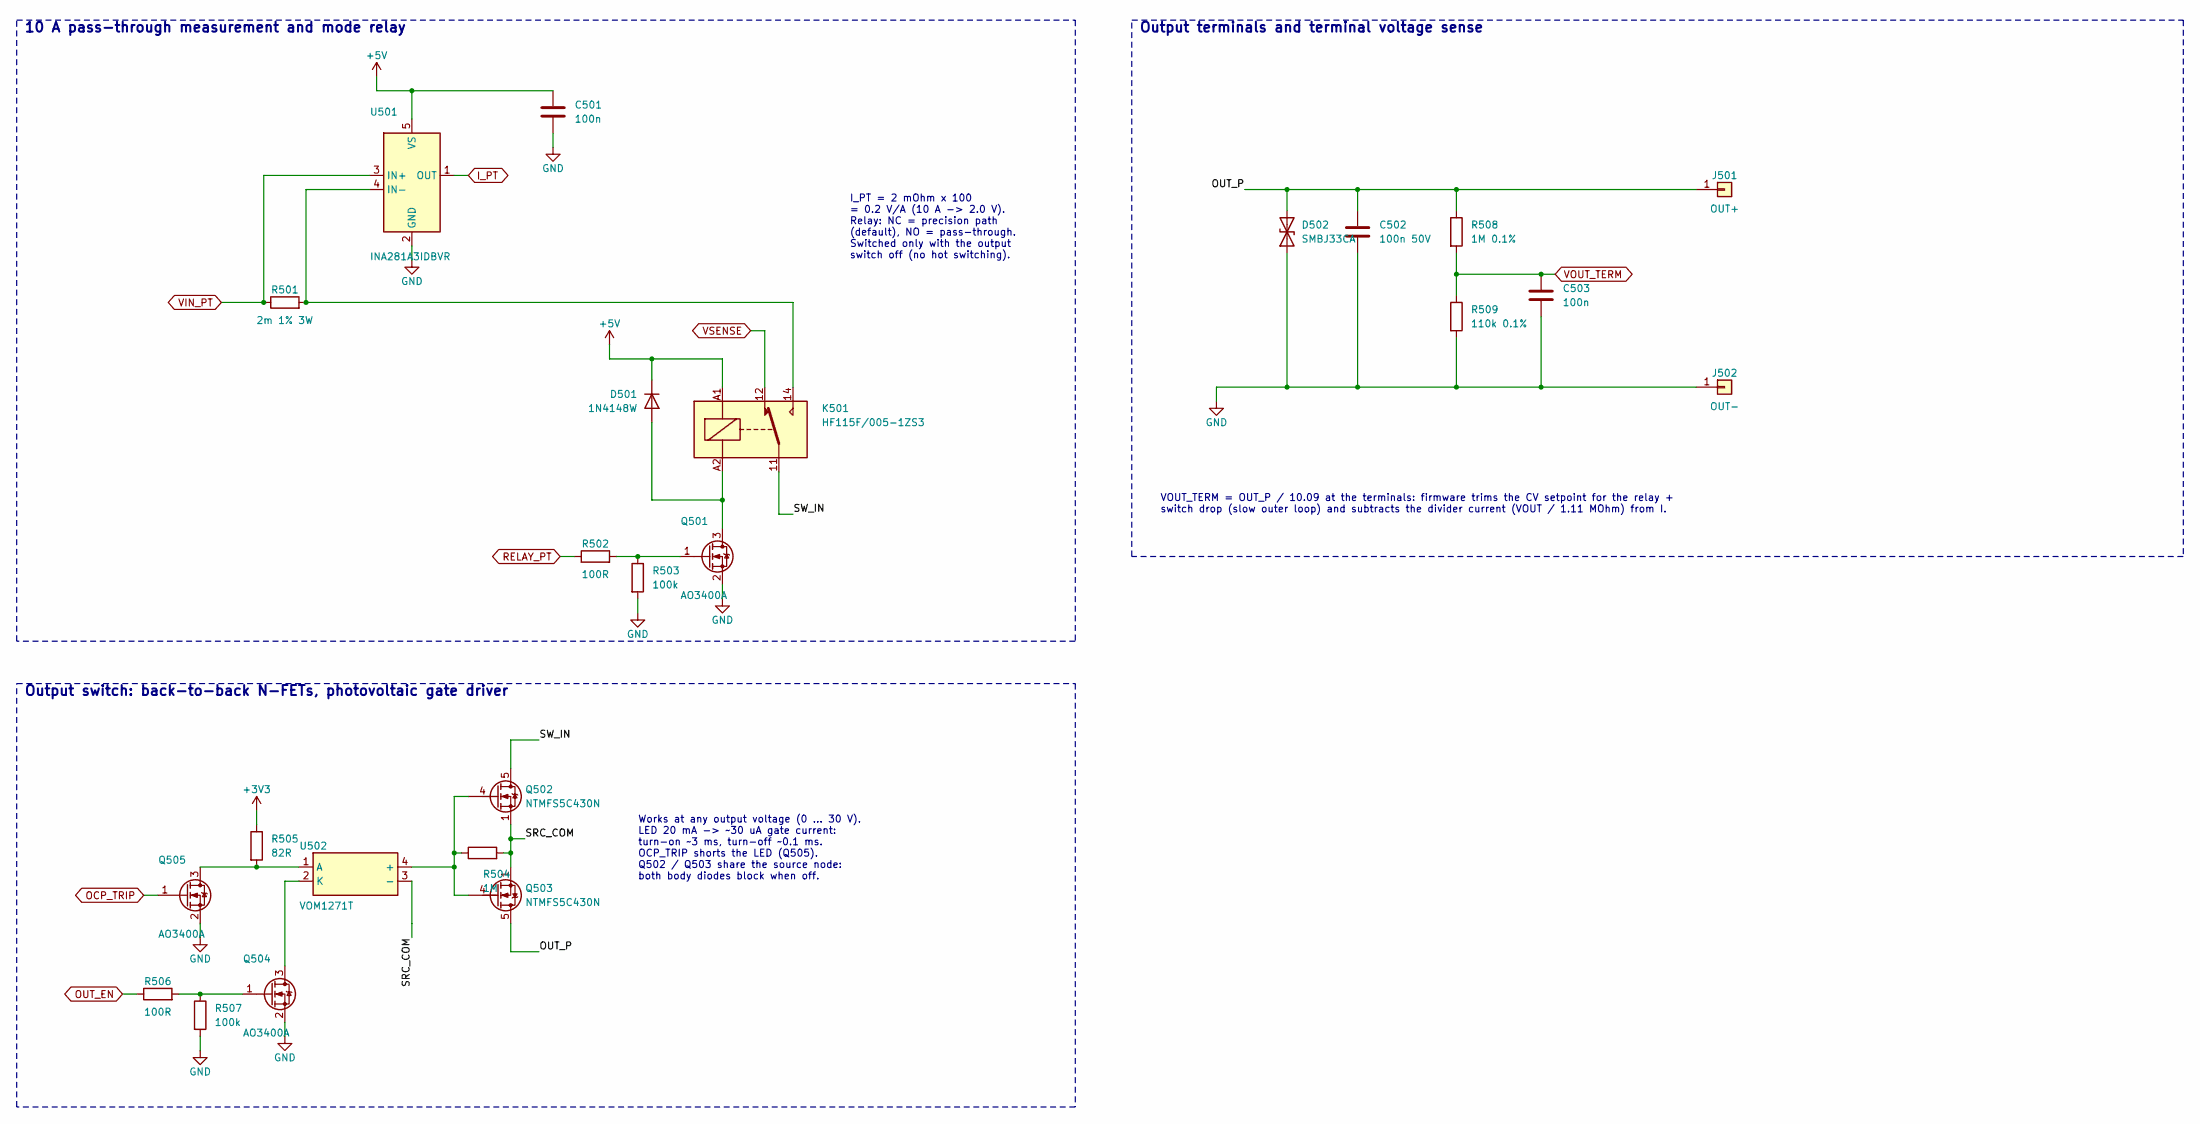
[picture p17: schematic output.kicad_sch, Pass-through & output switch]

Parts:
C501, C503: 100n; C_0603_1608Metric
C502: 100n 50V; C_0603_1608Metric
D501: 1N4148W; D_SOD-123
D502: SMBJ33CA; D_SMB; MPN SMBJ33CA (bidirectional)
J501: OUT+; Banana_Cliff_FCR7350R_S16N-PC_Horizontal; MPN Cliff FCR7350R
J502: OUT-; Banana_Cliff_FCR7350B_S16N-PC_Horizontal; MPN Cliff FCR7350B
K501: HF115F/005-1ZS3; Relay_SPDT_Schrack-RT1-16A-FormC_RM5mm; MPN Hongfa HF115F/005-1ZS3 (verify pin map 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; LCSC C9225
Q501, Q504, Q505: AO3400A; SOT-23; LCSC C20917
Q502, Q503: NTMFS5C430N; ONSemi_SO-8FL_488AA; LCSC C604436
R501: 2m 1% 3W; R_2512_6332Metric; LCSC C459679
R502, R506: 100R; R_0603_1608Metric
R503, R507: 100k; R_0603_1608Metric
R504: 1M; R_0603_1608Metric
R505: 82R; R_0603_1608Metric
R508: 1M 0.1%; R_0603_1608Metric
R509: 110k 0.1%; R_0603_1608Metric
U501: INA281A3IDBVR; SOT-23-5; LCSC C1517407
U502: VOM1271T; SO-4_4.4x3.6mm_P2.54mm; MPN Vishay VOM1271T (check output polarity: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; LCSC C146286

Connections:
+3V3: R505.1; also elsewhere on the board
+5V: C501.1, D501.1 (K), K501.A1, U501.5 (VS); also elsewhere on the board
/Pass-through & output switch/OUT_P: C502.1, D502.2 (A2), J501.1, Q503.5 (D), R508.1
/Pass-through & output switch/SRC_COM: Q502.1 (S), Q502.2 (S), Q502.3 (S), Q503.1 (S), Q503.2 (S), Q503.3 (S), R504.2, U502.3 (-)
/Pass-through & output switch/SW_IN: K501.11, Q502.5 (D)
GND: C501.2, C502.2, C503.2, D502.1 (A1), J502.1, Q501.2 (S), Q504.2 (S), Q505.2 (S), R503.2, R507.2, R509.2, U501.2 (GND); also elsewhere on the board
I_PT: U501.1 (OUT); also elsewhere on the board
unnamed: D501.2 (A), K501.A2, Q501.3 (D)
unnamed: Q501.1 (G), R502.2, R503.1
unnamed: Q502.4 (G), Q503.4 (G), R504.1, U502.4 (+)
unnamed: Q504.3 (D), U502.2 (K)
unnamed: Q504.1 (G), R506.2, R507.1
unnamed: Q505.3 (D), R505.2, U502.1 (A)
unnamed: K501.14, R501.2, U501.4 (IN-)
OCP_TRIP: Q505.1 (G); also elsewhere on the board
OUT_EN: R506.1; also elsewhere on the board
RELAY_PT: R502.1; also elsewhere on the board
VIN_PT: R501.1, U501.3 (IN+); also elsewhere on the board
VOUT_TERM: C503.1, R508.2, R509.1; also elsewhere on the board
VSENSE: K501.12; also elsewhere on the board

Notes on the sheet:
10 A pass-through measurement and mode relay
I_PT = 2 mOhm x 100 = 0.2 V/A (10 A -> 2.0 V). Relay: NC = precision path (default), NO = pass-through. Switched only with the output switch off (no hot switching).
Output switch: back-to-back N-FETs, photovoltaic gate driver
Works at any output voltage (0 ... 30 V). LED 20 mA -> ~30 uA gate current: turn-on ~3 ms, turn-off ~0.1 ms. OCP_TRIP shorts the LED (Q505). Q502 / Q503 share the source node: both body diodes block when off.
Output terminals and terminal voltage sense
VOUT_TERM = OUT_P / 10.09 at the terminals: firmware trims the CV setpoint for the relay + switch drop (slow outer loop) and subtracts the divider current (VOUT / 1.11 MOhm) from I.

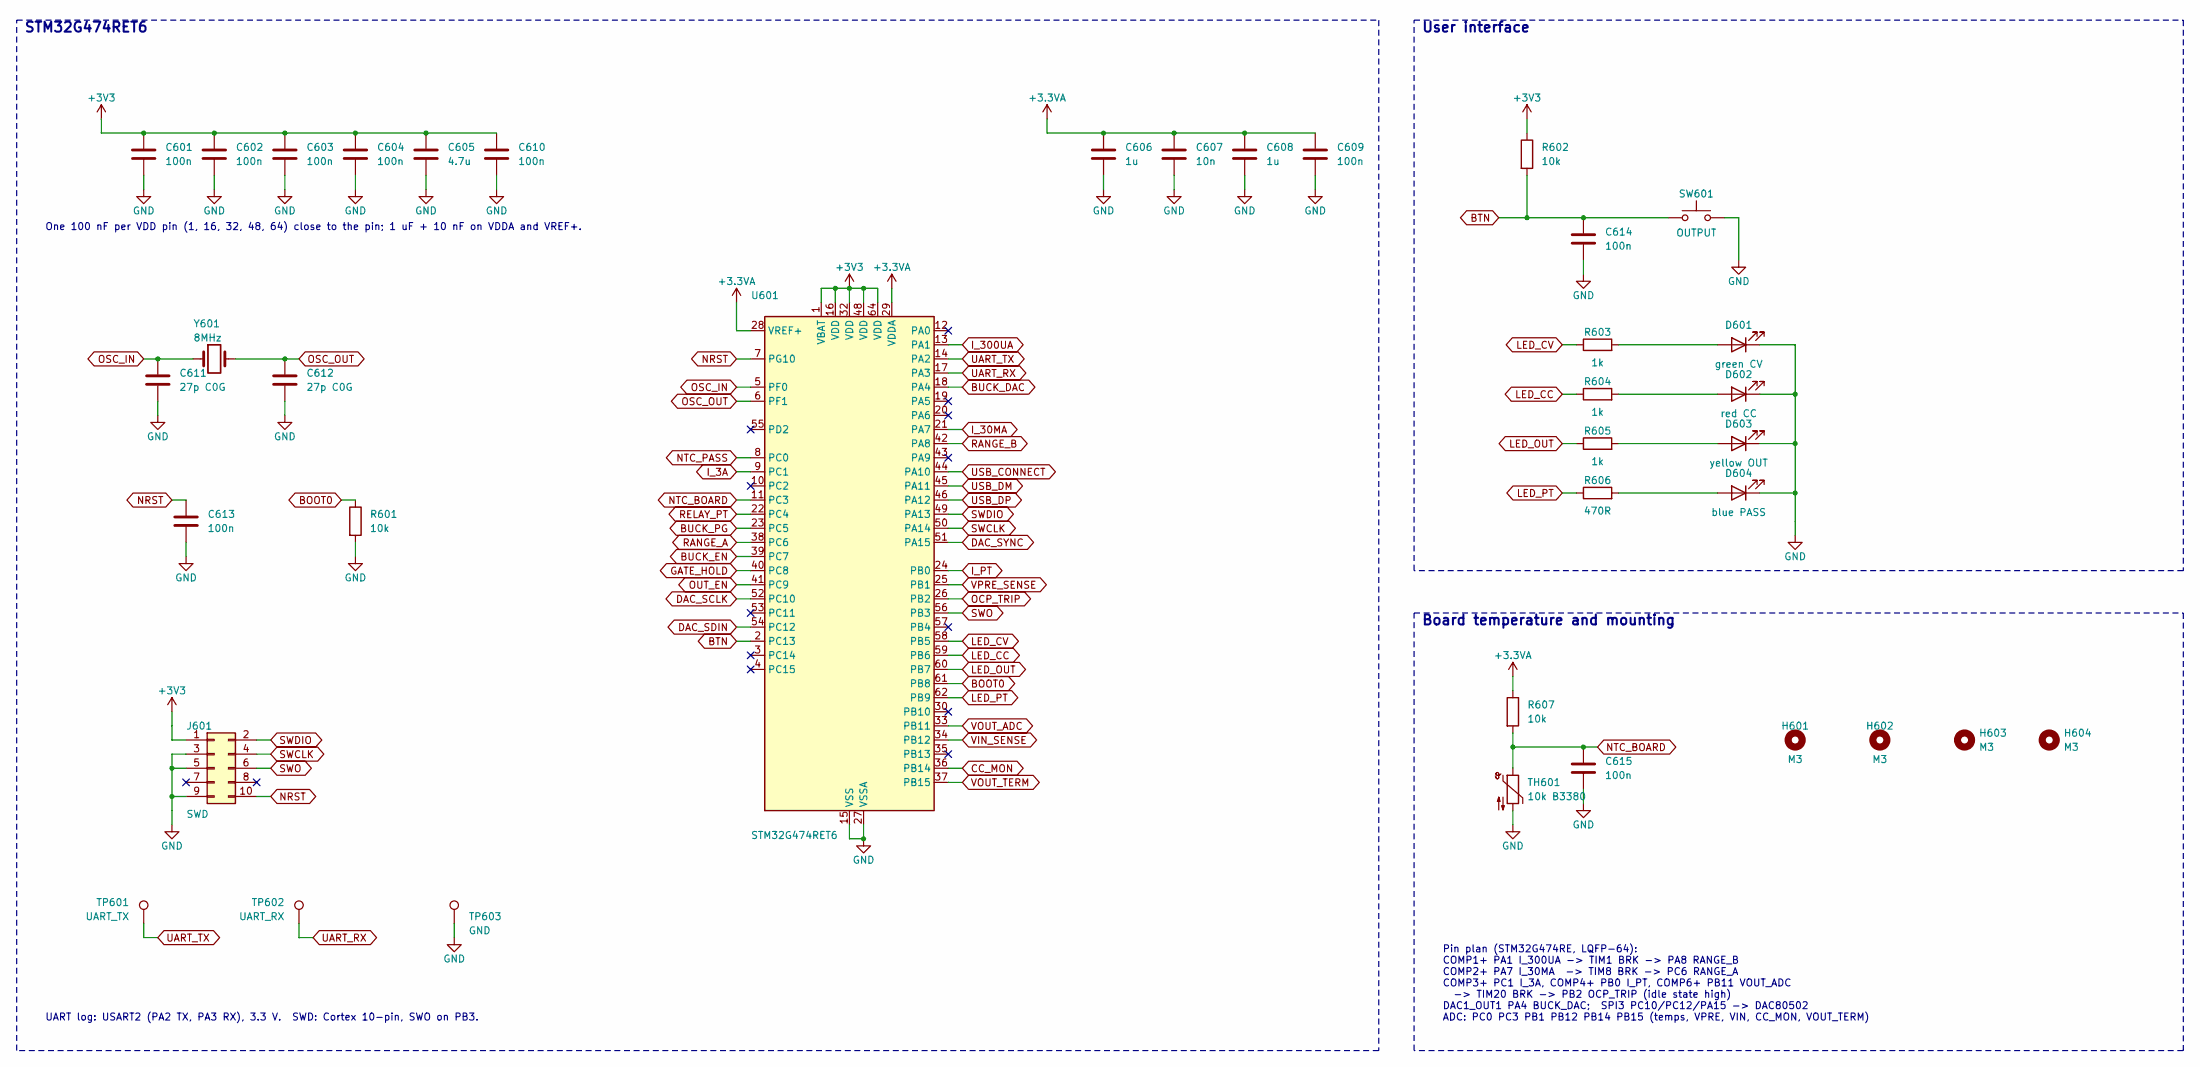
[picture p18: schematic mcu.kicad_sch, MCU, debug & user interface]

Parts:
C601, C602, C603, C604, C609, C610, C613, C614, C615: 100n; C_0603_1608Metric
C605: 4.7u; C_0805_2012Metric
C606, C608: 1u; C_0603_1608Metric
C607: 10n; C_0603_1608Metric
C611, C612: 27p C0G; C_0603_1608Metric
D601: green CV; LED_0603_1608Metric
D602: red CC; LED_0603_1608Metric
D603: yellow OUT; LED_0603_1608Metric
D604: blue PASS; LED_0603_1608Metric
H601, H602, H603, H604: M3; MountingHole_3.2mm_M3
J601: SWD; PinHeader_2x05_P1.27mm_Vertical_SMD; MPN Cortex debug 2x5 1.27 mm; LCSC C5160761
R601, R602, R607: 10k; R_0603_1608Metric
R603, R604, R605: 1k; R_0603_1608Metric
R606: 470R; R_0603_1608Metric
SW601: OUTPUT; SW_SPST_PTS645
TH601: 10k B3380; R_0603_1608Metric; LCSC C13564
TP601: UART_TX; TestPoint_Pad_D1.5mm
TP602: UART_RX; TestPoint_Pad_D1.5mm
TP603: GND; TestPoint_Pad_D1.5mm
U601: STM32G474RET6; LQFP-64_10x10mm_P0.5mm; MPN STM32G474RET6 (fallback STM32G431RBT6, 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; LCSC C521608
Y601: 8MHz; Crystal_SMD_HC49-SD; LCSC C12674

Connections:
+3.3VA: C606.1, C607.1, C608.1, C609.1, R607.1, U601.28 (VREF+), U601.29 (VDDA); also elsewhere on the board
+3V3: C601.1, C602.1, C603.1, C604.1, C605.1, C610.1, J601.1, R602.1, U601.1 (VBAT), U601.16 (VDD), U601.32 (VDD), U601.48 (VDD), U601.64 (VDD); also elsewhere on the board
BOOT0: R601.1, U601.61 (PB8)
BTN: C614.1, R602.2, SW601.1, U601.2 (PC13)
BUCK_DAC: U601.18 (PA4); also elsewhere on the board
BUCK_EN: U601.39 (PC7); also elsewhere on the board
BUCK_PG: U601.23 (PC5); also elsewhere on the board
CC_MON: U601.36 (PB14); also elsewhere on the board
DAC_SCLK: U601.52 (PC10); also elsewhere on the board
DAC_SDIN: U601.54 (PC12); also elsewhere on the board
DAC_SYNC: U601.51 (PA15); also elsewhere on the board
GATE_HOLD: U601.40 (PC8); also elsewhere on the board
GND: C601.2, C602.2, C603.2, C604.2, C605.2, C606.2, C607.2, C608.2, C609.2, C610.2, C611.2, C612.2, C613.2, C614.2, C615.2, D601.1 (K), D602.1 (K), D603.1 (K), D604.1 (K), J601.3, J601.5, J601.9, R601.2, SW601.2, TH601.2, TP603.1, U601.15 (VSS), U601.27 (VSSA), U601.31 (VSS), U601.47 (VSS), U601.63 (VSS); also elsewhere on the board
I_3A: U601.9 (PC1); also elsewhere on the board
I_30MA: U601.21 (PA7); also elsewhere on the board
I_300UA: U601.13 (PA1); also elsewhere on the board
I_PT: U601.24 (PB0); also elsewhere on the board
LED_CC: R604.1, U601.59 (PB6)
LED_CV: R603.1, U601.58 (PB5)
LED_OUT: R605.1, U601.60 (PB7)
LED_PT: R606.1, U601.62 (PB9)
NRST: C613.1, J601.10, U601.7 (PG10)
NTC_BOARD: C615.1, R607.2, TH601.1, U601.11 (PC3)
NTC_PASS: U601.8 (PC0); also elsewhere on the board
unnamed: D601.2 (A), R603.2
unnamed: D602.2 (A), R604.2
unnamed: D603.2 (A), R605.2
unnamed: D604.2 (A), R606.2
OCP_TRIP: U601.26 (PB2); also elsewhere on the board
OSC_IN: C611.1, U601.5 (PF0), Y601.1
OSC_OUT: C612.1, U601.6 (PF1), Y601.2
OUT_EN: U601.41 (PC9); also elsewhere on the board
RANGE_A: U601.38 (PC6); also elsewhere on the board
RANGE_B: U601.42 (PA8); also elsewhere on the board
RELAY_PT: U601.22 (PC4); also elsewhere on the board
SWCLK: J601.4, U601.50 (PA14)
SWDIO: J601.2, U601.49 (PA13)
SWO: J601.6, U601.56 (PB3)
UART_RX: TP602.1, U601.17 (PA3)
UART_TX: TP601.1, U601.14 (PA2)
USB_CONNECT: U601.44 (PA10); also elsewhere on the board
USB_DM: U601.45 (PA11); also elsewhere on the board
USB_DP: U601.46 (PA12); also elsewhere on the board
VIN_SENSE: U601.34 (PB12); also elsewhere on the board
VOUT_ADC: U601.33 (PB11); also elsewhere on the board
VOUT_TERM: U601.37 (PB15); also elsewhere on the board
VPRE_SENSE: U601.25 (PB1); also elsewhere on the board

Notes on the sheet:
STM32G474RET6
One 100 nF per VDD pin (1, 16, 32, 48, 64) close to the pin; 1 uF + 10 nF on VDDA and VREF+.
UART log: USART2 (PA2 TX, PA3 RX), 3.3 V. SWD: Cortex 10-pin, SWO on PB3.
User interface
Board temperature and mounting
Pin plan (STM32G474RE, LQFP-64): COMP1+ PA1 I_300UA -> TIM1 BRK -> PA8 RANGE_B COMP2+ PA7 I_30MA -> TIM8 BRK -> PC6 RANGE_A COMP3+ PC1 I_3A, COMP4+ PB0 I_PT, COMP6+ PB11 VOUT_ADC -> TIM20 BRK -> PB2 OCP_TRIP (idle state high) DAC1_OUT1 PA4 BUCK_DAC; SPI3 PC10/PC12/PA15 -> DAC80502 ADC: PC0 PC3 PB1 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

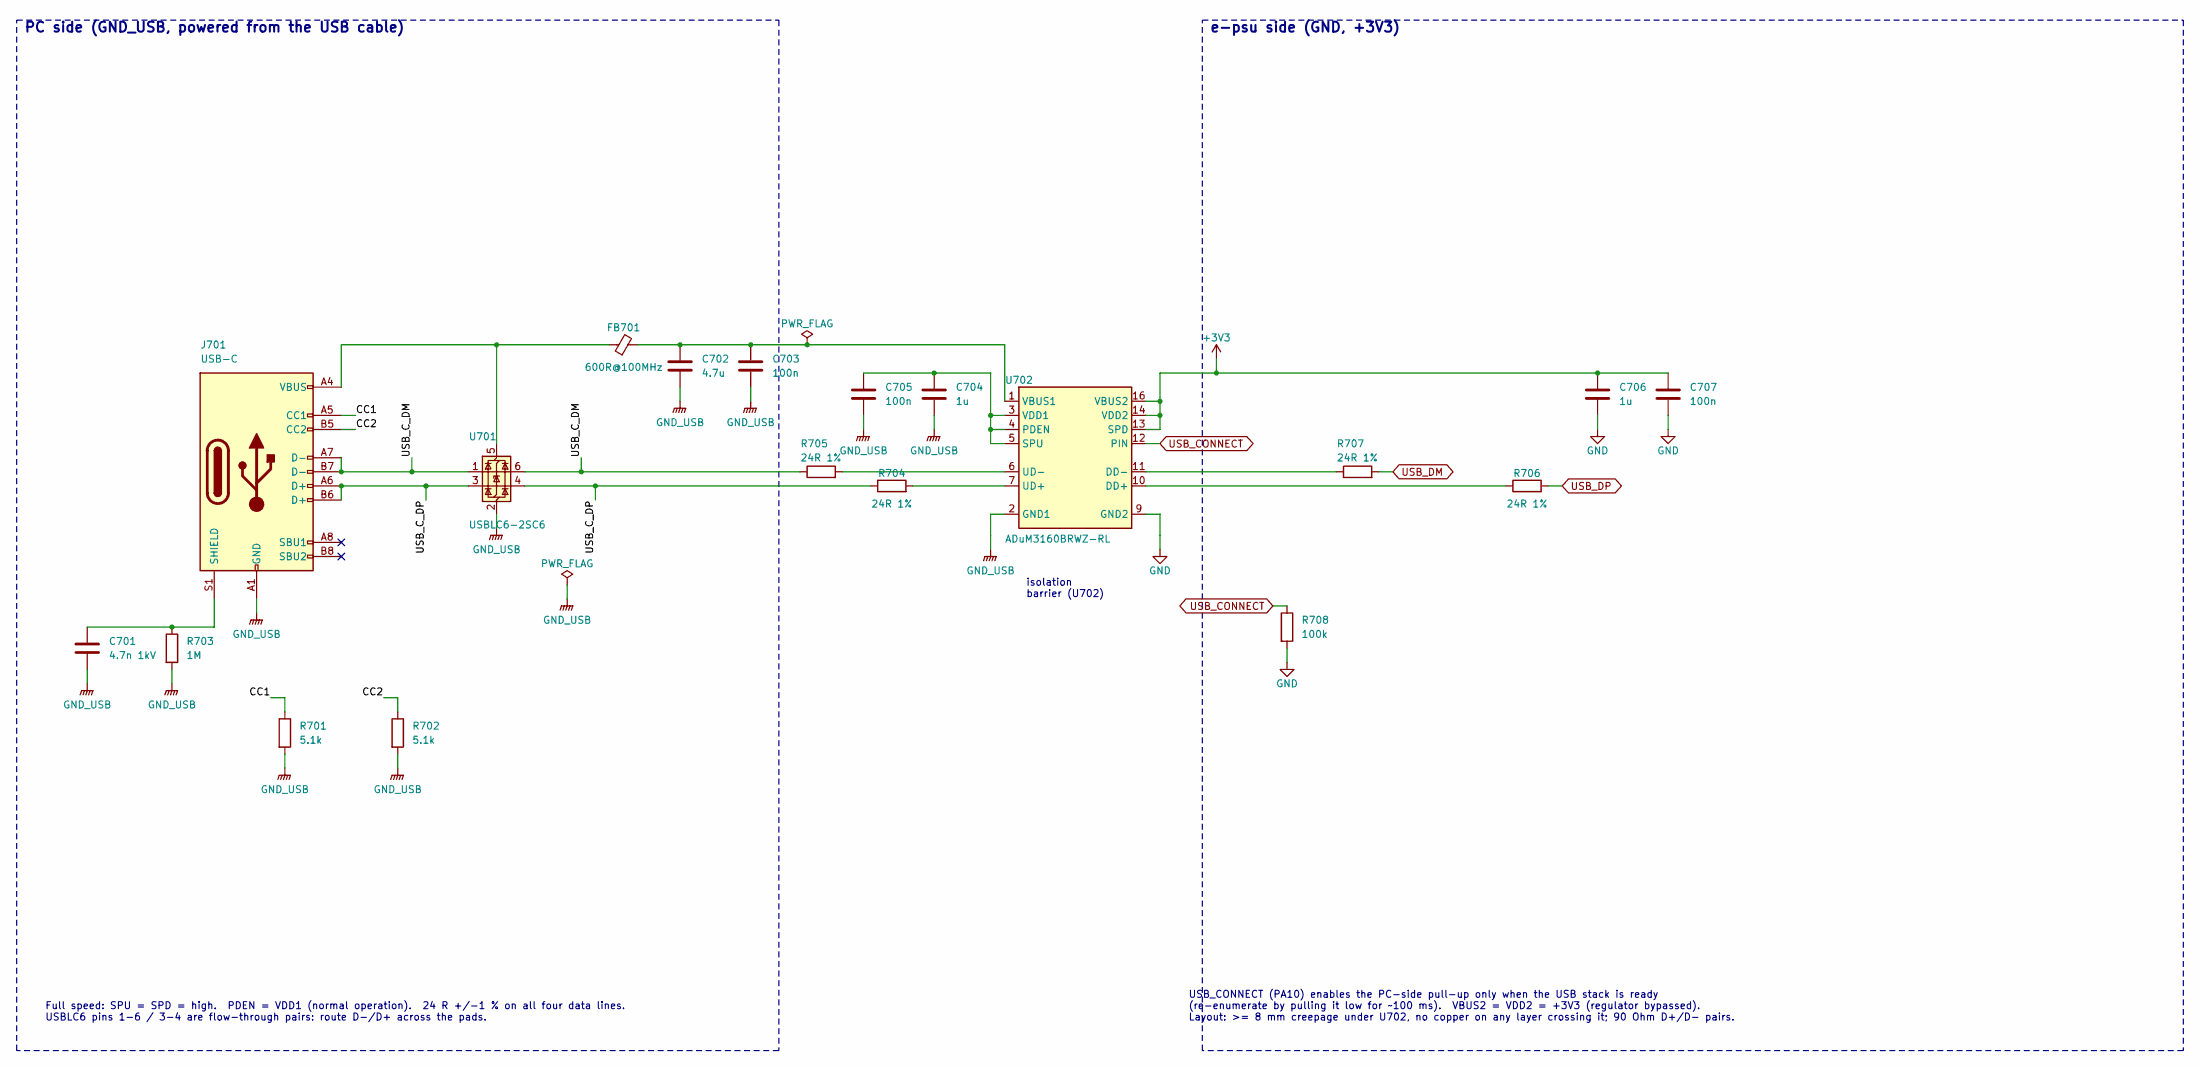
[picture p19: schematic usb.kicad_sch, Isolated USB]

Parts:
C701: 4.7n 1kV; C_1206_3216Metric
C702: 4.7u; C_0805_2012Metric
C703, C705, C707: 100n; C_0603_1608Metric
C704, C706: 1u; C_0603_1608Metric
FB701: 600R@100MHz; L_0805_2012Metric
J701: USB-C; USB_C_Receptacle_HRO_TYPE-C-31-M-12; LCSC C165948
R701, R702: 5.1k; R_0603_1608Metric
R703: 1M; R_0603_1608Metric
R704, R705, R706, R707: 24R 1%; R_0603_1608Metric
R708: 100k; R_0603_1608Metric
U701: USBLC6-2SC6; SOT-23-6; LCSC C7519
U702: ADuM3160BRWZ-RL; SOIC-16W_7.5x10.3mm_P1.27mm; LCSC C284149

Connections:
+3V3: C706.1, C707.1, U702.13 (SPD), U702.14 (VDD2), U702.16 (VBUS2); also elsewhere on the board
/Isolated USB/CC1: J701.A5 (CC1), R701.1
/Isolated USB/CC2: J701.B5 (CC2), R702.1
/Isolated USB/USB_C_DM: J701.A7 (D-), J701.B7 (D-), R705.1, U701.1 (I/O1), U701.6 (I/O1)
/Isolated USB/USB_C_DP: J701.A6 (D+), J701.B6 (D+), R704.1, U701.3 (I/O2), U701.4 (I/O2)
GND: C706.2, C707.2, R708.2, U702.9 (GND2), U702.15 (GND2); also elsewhere on the board
GND_USB: C701.2, C702.2, C703.2, C704.2, C705.2, J701.A1 (GND), J701.A12 (GND), J701.B1 (GND), J701.B12 (GND), R701.2, R702.2, R703.2, U701.2 (GND), U702.2 (GND1), U702.8 (GND1)
unnamed: C701.1, J701.S1 (SHIELD), R703.1
unnamed: FB701.1, J701.A4 (VBUS), J701.A9 (VBUS), J701.B4 (VBUS), J701.B9 (VBUS), U701.5 (VBUS)
unnamed: R706.1, U702.10 (DD+)
unnamed: R707.1, U702.11 (DD-)
unnamed: C704.1, C705.1, U702.3 (VDD1), U702.4 (PDEN), U702.5 (SPU)
unnamed: R704.2, U702.7 (UD+)
unnamed: R705.2, U702.6 (UD-)
unnamed: C702.1, C703.1, FB701.2, U702.1 (VBUS1)
USB_CONNECT: R708.1, U702.12 (PIN); also elsewhere on the board
USB_DM: R707.2; also elsewhere on the board
USB_DP: R706.2; also elsewhere on the board

Notes on the sheet:
PC side (GND_USB, powered from the USB cable)
e-psu side (GND, +3V3)
isolation barrier (U702)
Full speed: SPU = SPD = high. PDEN = VDD1 (normal operation). 24 R +/-1 % on all four data lines. USBLC6 pins 1-6 / 3-4 are flow-through pairs: route D-/D+ across the pads.
USB_CONNECT (PA10) enables the PC-side pull-up only when the USB stack is ready (re-enumerate by pulling it low for ~100 ms). VBUS2 = VDD2 = +3V3 (regulator bypassed). Layout: >= 8 mm creepage under U702, no copper on any layer crossing it; 90 Ohm D+/D- pairs.

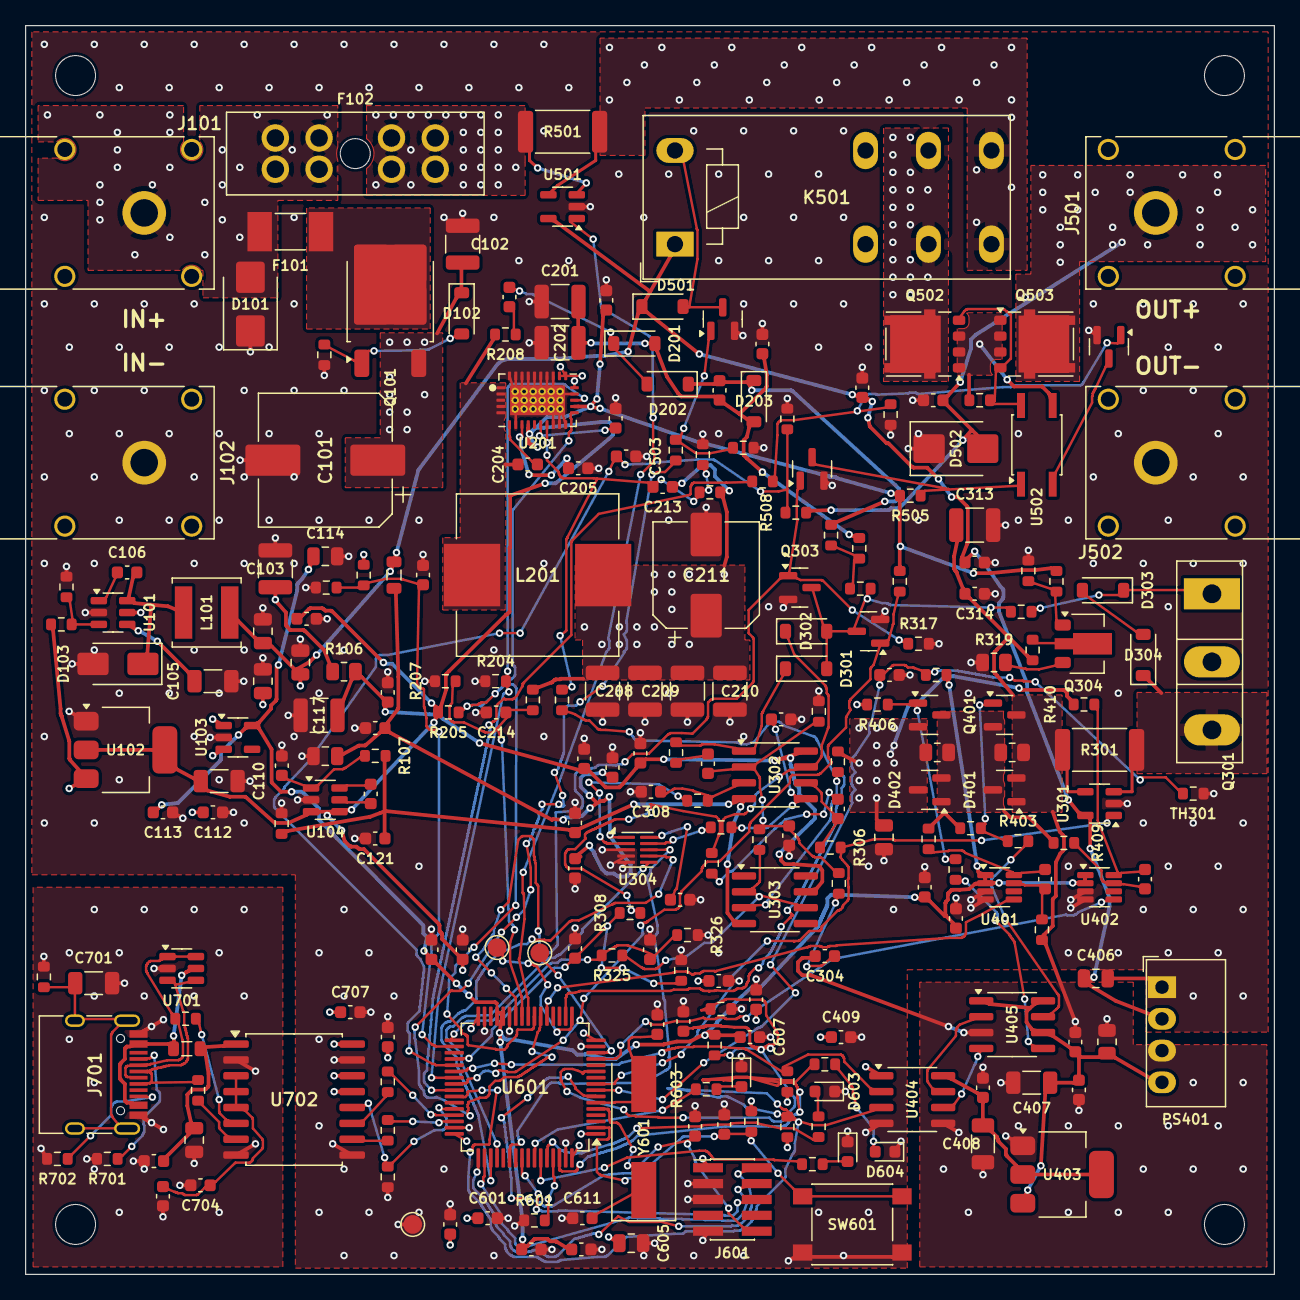
[picture p20: board e-psu.kicad_pcb from above]

Board: 4 copper layers, 100.0 x 100.0 mm, 244 parts (0 on the bottom side), 131 nets.
