embedded-pro/e-psu-hardware/(commit log)

2026-11-04 Initial commit: e-psu rev A hardware
    - KiCad 7 schematic (rev A1, 8 sheets) with project symbols and footprints
    - 4-layer 100 x 100 mm PCB, fully routed (DRC: 0 errors, 0 unconnected)
    - Board build scripts: placement, power copper, fan-out, grid router, fab outputs
    - JLCPCB Gerbers, drill, BOM, CPL and renders
    - ngspice simulation suite of the analog stage, with report and plots
    - Schematic generator and project context
    U201 (LM76003, TI RNP0030B) footprint is provisional.
    Claude-Session: https://claude.ai/code/session_014WUWh89GUoMYam5KVVK41W
    [buck.kicad_sch, cc_asdrawn.csv, cc_proposed.csv, cv_asdrawn.csv, cv_proposed.csv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]
2026-11-04 chore: align repository with the e-foc-hardware layout
    - Move the KiCad project to hardware/e-psu/ (project files unchanged)
    - Move the board generator to scripts/pcb/, the schematic generator to
    scripts/schgen/ and the ngspice suite to simulation/
    - Add the e-foc export helpers (export_review, export_jlcpcb,
    export_release, visual_diff) for the e-psu board
    - Add CI: kicad-bot ERC/DRC, visual diff on PRs, release-please releases
    with a fabrication bundle per release
    - Stop tracking generated outputs (fab/, netlists, schematic PDF); the
    board generator now exports the netlist from the schematic on each build
    - Add an e-foc-style README with the spec table, a component-agnostic
    PSU d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
    [buck.kicad_sch, cc_asdrawn.csv, cc_proposed.csv, cv_asdrawn.csv, cv_proposed.csv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]
